jagathsrujan/mcp2515-can-bus-module/docs/pcb/drc_report.txt

** Drc report for MCP2515_CAN.kicad_pcb **
** Created on 2026-11-03T07:28:12 **
** Report includes: Errors, Warnings, Exclusions **

** Found 0 DRC violations **

** Found 0 unconnected pads **

** Found 0 Footprint errors **

** Ignored checks **
    - Footprint has no courtyard defined
    - Track endpoint not centered on via
    - Tuning profile track geometries
    - Footprint doesn't match symbol's footprint filters
    - Footprint component type doesn't match footprint pads

** End of Report **
