jagathsrujan/mcp2515-can-bus-module/docs/pcb/layout_report.md

# Phase 7 - PCB layout report (MCP2515 CAN module, Rev A)

Board: `kicad/MCP2515_CAN/MCP2515_CAN.kicad_pcb`, KiCad 10.0.8, 2-layer 1.6 mm, **70 x 50 mm** (plan 60x45 first; grown to the plan's 70x50 maximum, see Deviations). Origin = aux/grid origin at bottom-left (CPL positions below are X right, Y up in mm from that corner). Generated by scripts in the session scratchpad (placement legalizer, grid A* router, zone/stitching/silk scripts); CAN pair routed by hand-coordinates.

## 0. Footprint verification
| Part | Result | Source |
|---|---|---|
| J1 PJ-002AH (P-01) | Pad positions **verified correct**: pin1 (centre, slot 1.00x3.50) at origin, pin2 (sleeve, 1.00x3.00) 6.0 mm on-axis, pin3 (switch, 3.00x1.00) 3.0 along / 4.7 off-axis; jack front 10.7 mm ahead of pin3. Slots plated, finished slot = tab + 0.5 mm (tabs 3.0/2.5 wide, 0.25-0.4 thick). Pads 3.5x4.5 / 3.0x4.0 / 4.0x3.0 (>=0.5 mm ring). Fixed: courtyard (was y -5..10, now body 14.4x9.0 + pin3), silk moved off pads/edge, removed "PROVISIONAL" text, descr updated. | CUI PJ-002AH datasheet 10/30/2019 p2 (LCSC C2961147) |
| J3/J4/J5 KF128-5.08 (P-02) | Pin 0.9x0.8 mm (diag 1.2), recommended hole 1.4 +0.1, pitch 5.08, body 10.7 deep, pin 5.4 from body edge. Phoenix MKDS footprint had 1.3 mm drill (too tight): new project footprints `KF128-5.08-3P_Horizontal` / `-2P_Horizontal` with **1.4 mm drill, 2.6 mm pad (0.6 ring)**; outline/3D from Phoenix MKDS (approximation). | Kefa KF128-5.08 drawing (LCSC C474953 datasheet) |
| L2 ACT45B (P-03) | Land pattern kept (pads 1.35x0.9, DNP, R16/R17 fitted). Pin1 CANH_T upper-left, pins 1-4 / 2-3 windings match netlist. | TDK ACT45B p5 (earlier work) |
| U1 SOIC-18W | pin1 top-left (CCW numbering) = MCP2515 pin1 TXCAN; placed rot 180. | KiCad lib, MCP2515 DS |
| U2 SOIC-8 TCAN1042 | pin1 TXD, 2 GND, 3 VCC, 4 RXD, 5 VIO, 6 CANL, 7 CANH, 8 STB = netlist. | TCAN1042 DS |
| U3 TSOT-23-6 AP63205 | 1 FB, 2 EN, 3 VIN, 4 GND, 5 SW, 6 BST = netlist. U4 SOT-23-3 XC6206: 1 GND, 2 OUT, 3 IN = netlist. | datasheets |
| D1 SS34 / D2 SMAJ18A (D_SMA) | pin1 = cathode: D1 K on VIN_PROT (A on VIN_F), D2 K on VIN_PROT, A GND. D3 SOT-23 PESD2CANFD27V: 1 CANH, 2 CANL, 3 GND. D4 LED 0603: pin1 K=GND, pin2 A. | netlist / KiCad conventions |
| C1 CP_Elec_6.3x7.7 | pad1 = +, on VIN_PROT. Y1 3225-4: pins 1/3 crystal (OSC1/OSC2_X), 2/4 GND. | KiCad lib |

Schematic edit (non-electrical): Footprint field of J3, J4, J5 changed to `MCP2515_CAN:KF128-5.08-3P_Horizontal` / `-2P_...` so DRC schematic parity stays clean. ERC re-run: 0 violations. Originals backed up in the scratchpad.

## 1. Placement (X, Y up from bottom-left, rot deg CCW; footprint origin)
| Ref | X | Y | Rot |
|---|---|---|---|
| C1 | 35.00 | 9.50 | 0 |
| C10 | 34.85 | 44.00 | -90 |
| C11 | 31.78 | 42.20 | -90 |
| C12 | 35.65 | 24.60 | 90 |
| C13 | 36.00 | 20.50 | 0 |
| C14 | 42.90 | 20.50 | 0 |
| C15 | 33.15 | 35.85 | 90 |
| C16 | 37.00 | 29.25 | -90 |
| C17 | 16.26 | 23.92 | 180 |
| C18 | 11.50 | 41.00 | 180 |
| C19 | 56.00 | 38.50 | 0 |
| C2 | 42.90 | 10.00 | 90 |
| C3 | 42.90 | 15.25 | 90 |
| C4 | 47.00 | 6.90 | 0 |
| C5 | 52.50 | 16.00 | 180 |
| C6 | 52.50 | 19.05 | 180 |
| C7 | 49.20 | 13.40 | 0 |
| C8 | 44.90 | 41.50 | 0 |
| C9 | 36.90 | 40.55 | 180 |
| D1 | 25.50 | 9.50 | 180 |
| D2 | 25.50 | 4.50 | 180 |
| D3 | 62.00 | 25.70 | 0 |
| D4 | 45.70 | 3.50 | 0 |
| F1 | 19.00 | 9.50 | 0 |
| FB1 | 36.00 | 15.50 | 0 |
| FID1 | 3.50 | 35.00 | 0 |
| FID2 | 45.00 | 46.50 | 0 |
| FID3 | 57.00 | 3.50 | 0 |
| H1 | 66.50 | 3.00 | 0 |
| H2 | 3.50 | 46.50 | 0 |
| J1 | 13.70 | 9.50 | 0 |
| J2 | 31.78 | 45.60 | -90 |
| J3 | 64.35 | 30.75 | 90 |
| J4 | 64.35 | 10.50 | 90 |
| J5 | 5.65 | 25.00 | -90 |
| JP1 | 48.00 | 33.54 | 0 |
| L1 | 51.80 | 10.00 | 0 |
| L2 | 48.00 | 24.60 | 0 |
| R1 | 42.00 | 3.50 | 0 |
| R10 | 15.00 | 27.00 | 0 |
| R11 | 50.00 | 37.00 | 0 |
| R12 | 54.50 | 36.25 | 0 |
| R13 | 54.50 | 31.00 | 0 |
| R14 | 54.50 | 33.40 | 0 |
| R15 | 42.50 | 28.80 | 0 |
| R16 | 48.00 | 27.75 | 0 |
| R17 | 48.00 | 21.45 | 0 |
| R2 | 15.25 | 42.50 | 0 |
| R3 | 14.50 | 39.50 | 90 |
| R4 | 31.00 | 30.70 | -90 |
| R5 | 26.70 | 41.75 | 90 |
| R6 | 24.16 | 41.75 | 90 |
| R7 | 19.08 | 41.75 | 90 |
| R8 | 21.62 | 41.75 | 90 |
| R9 | 16.79 | 39.50 | 90 |
| SJ1 | 39.50 | 37.80 | 0 |
| TP1 | 31.00 | 14.75 | 0 |
| TP10 | 44.25 | 33.54 | 0 |
| TP11 | 48.30 | 18.30 | 0 |
| TP12 | 40.00 | 31.55 | 0 |
| TP2 | 56.50 | 6.75 | 0 |
| TP3 | 37.75 | 45.05 | 0 |
| TP4 | 41.00 | 46.00 | 0 |
| TP5 | 18.00 | 4.00 | 0 |
| TP6 | 32.00 | 26.00 | 0 |
| TP7 | 8.00 | 40.00 | 0 |
| TP8 | 32.00 | 22.00 | 0 |
| TP9 | 31.50 | 18.75 | 0 |
| U1 | 24.00 | 29.00 | 180 |
| U2 | 40.50 | 24.60 | 0 |
| U3 | 47.00 | 10.00 | 0 |
| U4 | 41.00 | 41.50 | 0 |
| Y1 | 34.00 | 31.70 | -90 |

Fixed: H1 (66.5,3.0), H2 (3.5,46.5) M3, 3 mm (r=4.6) keep-out rule areas; FID1 (3.5,35), FID2 (45,46.5), FID3 (57,3.5). J1/J5 face the left edge, J3/J4 the right edge (entry outward, 0.3 mm inset so silk clears the edge), J2 on the top edge, SMD courtyards >= 2.5 mm from edges (min 2.7 mm, TP4; D2 moved to y=4.5; fiducial courtyards 2.2 mm are exempt).

## 2. Rules / pours
Board setup + netclasses in `.kicad_pro`: min track/clearance 0.15/0.15, via 0.3/0.6, annular 0.15, hole-hole 0.5, edge 0.5, silk 0.15/1.0/0.15, mask 0.05/0.1; Default 0.20/0.20, Power 0.5/0.2 (0.3 fallback where space is tight: yes, some branches), SW 0.6/0.25, CAN 0.25 (gap 0.20).
Pours: Z1 B.Cu GND whole board, prio 0, clearance 0.3, min width 0.25, thermal relief (0.4 spoke / 0.3 gap) on THT GND pads, solid on SMD/vias, islands removed; Z2 F.Cu GND same; Z3 F.Cu VIN_PROT local pour (26.9-35.4, 3.4-16.4) prio 1; Z4 F.Cu +5V local pour at L1/C5/C6 prio 1; pour keep-out rule areas around both mounting holes. Z3 as built covers VIN_PROT only (D1.K, D2.K, C1+, FB1, TP1); no separate VIN_BUCK pour (0.5 mm traces, ~0.13 A).
Stitching/GND vias: 150 vias total, 126 GND = 27 at SMD GND pads (every decoupling-cap GND pad; D2 and D3 have >=2 each incl. stitching), 40 edge ring (~5 mm), 44 grid (~8 mm), 11 Y1 guard ring, 3 along the CAN pair. Bottom layer is a solid GND plane except signal jumpers (below).

## 3. Measured key checks (plan section 8)
- DRC (`kicad-cli pcb drc --all-track-errors --schematic-parity --severity-all`): **0 violations, 0 unconnected, 0 parity issues** (docs/pcb/drc_report.txt).
- Y1-L1 centre distance **28.1 mm** (>=10); Y1 to SW pad (U3.5) 25.9 mm; Y1 to nearest CAN-pair item (D3/L2/R16/JP1/U2 CAN pads) **11.1 mm** (>=5). Nothing but GND under Y1/C15/C16 on bottom (bottom keep-out for signals).
- Oscillator track length (pad centres): OSC1 5.85, OSC2 1.95, OSC2_X 5.76 mm (plan <=5 mm each: OSC1/OSC2_X **exceed by ~0.8-0.9 mm**, no vias, short symmetric top-layer; crystal placement limited by U1 courtyard).
- CAN pair (rev. after Opus review): **D3 now sits in the gap between J3 and J4 at (62.0,25.7)**, J3 moved to pin1 y=30.75, J4 to 10.5. Routed lengths pin -> D3 pad (pad centres): J3 CANH 18.89 / CANL 18.89 mm (straight 5.3 / 11.6); J4 CANH 25.56 / CANL 25.56 (straight 16.5 / 9.7); mismatch 0.00 on each. D3->U2 via R16/R17: 20.19 / 20.44 mm. The "<=5 mm routed" target is met only for J3 CANH (~5.3 straight); **not achievable for the other three pins**: J3/J4 pins are on a 5.08 mm pitch, so L3/H4/L4 are 9.7-16.5 mm from any single D3 position. Routing order is J3/J4 -> D3 pads -> trunk -> JP1/R11-R14 -> R16/R17 (L2) -> U2; D3 GND pad has 2 dedicated GND vias at (64.8,25.7)/(66.4,25.7) plus 2 stitching vias nearby. 0.25 mm tracks on the top layer; 4 vias (two bottom jumpers, CANL via 58.8 mm column and CANH via 58.0 column) because J3/J4 pin order alternates H,L,H,L; short stubs carry detours/one meander each (right-hand detours) to equalise lengths.
- Decoupling (cap power pad centre -> IC pin pad centre; edge gap in brackets approx.): C4->U3.3 2.18 mm, C8->U4.3 1.99, C9->U4.2 2.01, C14->U2.5 2.35, C12->U2.3 2.38, C17->U1.18 2.31, C11->J2.1 2.62, C2->U3.3 3.01; bulk C10 3.1, C13 4.6, C3 5.6, C5 6.0, C6 9.1 (bulk, not pin-critical). Wide SOIC pads make centre-centre >2 mm unavoidable at 0.25 mm courtyard gaps; pad-edge gaps are all <=1.9 mm. Every cap has a GND via at its GND pad.
- Buck hot loop C4-U3 (VIN_BUCK/GND pads, trapezoid C4.1,U3.3,U3.4,C4.2): **4.1 mm2** (<10); C4 directly below U3. SW is a 0.6 mm top-layer track U3.5 -> L1.1 (+C7), no vias, GND plane below; FB routed as a separate 0.3 mm trace to the C6 +5V pad.
- GND plane continuity: B.Cu pour one single outline (verified, only the CAN jumper and few signal jumper traces cut it); top pour has 5 islands, each stitched to B.Cu by vias (DRC clean).
- Silk: all text 1.0 mm / 0.15; refs only for ICs/connectors/diodes/etc., passives refs on F.Fab; silk-to-pad and silk-edge DRC 0.

## 4. Tool results
- MCP `get_courtyard_violations`: none. `get_silk_to_pad_violations`: none. `dfm_load_manufacturer_profile` JLCPCB/standard + `dfm_run_manufacturer_check`: PASS DRC 0, unconnected 0, courtyard 0, silk 0; WARN (profile cannot read board-level min track/via/layers without a live KiCad session; manual review items: annular ring, copper-edge, silk height - all met by DRC rules above).
- MCP `emc_*` tools need an open KiCad IPC session (BOARD_NOT_OPEN) - not run; equivalents measured above. `pcb_critique_placement`: warnings are heuristic (e.g. bulk caps vs nearest IC, FB1 taken as a "crystal") - none affect the actual constraints.
- Exports: STEP, renders (top/bottom/iso), F.Cu/B.Cu images (pour and tracks-only) in docs/pcb/.

## 5. Deviations / open items
1. Board 70x50 instead of 60x45: SMD courtyard margins, 12 test points, two 15 mm terminal blocks plus 5 mm header and 0.25-0.5 mm courtesy gaps could not be packed in 60x45.
2. CAN pair has **4 vias** (CANH and CANL bottom jumpers next to D3) and TX/RX/INT/MISO-type signals use a few bottom jumpers (STB, RXCAN, INT_U/INT_N, RST). Reason (CAN): J3 and J4 are identical outward terminals so pin order H,L,H,L along the edge is topologically non-planar on one layer; frozen schematic forbids swapping. Plan stated "no vias" - report.
3. OSC1/OSC2_X 5.8 mm (>5 mm target).
4. The CAN pair is not tightly coupled over its whole length (D3 pads/R16/R17/L2 geometry); skew is zero by construction.
5. Decoupling caps: centre-distance >2 mm for wide-pad ICs (see list); edge gaps <=2 mm.
6. Power tracks: some 0.3 mm instead of 0.5 mm; +5V and VIO routes are long diagonals (auto-routed) - functional, DRC clean, cosmetic.
7. No VIN_BUCK pour; Z3/Z4 are modest local pours.
8. J3-J5 use Phoenix 3D model (approximate); J1 has no 3D model (blank in renders).
9. Schematic footprint fields for J3/J4/J5 changed (non-electrical). docs BOM CSVs from phase 6 still show the old footprint name.
10. JLC order-number placeholder text and silk board name are present; legend of J2 pins uses two staggered rows above the header.

11. Rev. review fixes: D3 relocated to J3/J4 gap (see section 3); D2 edge clearance fixed; silk: "+" next to J5 pin 1 and "9V + centre" beside J1.
