jagathsrujan/mcp2515-can-bus-module/docs/schematic/erc_report.txt

ERC report (2026-11-03T06:22:05, Encoding UTF8)
Report includes: Errors, Warnings

***** Sheet /

***** Sheet /Power/

***** Sheet /Controller/

***** Sheet /CAN PHY/

 ** ERC messages: 0  Errors 0  Warnings 0

 ** Ignored checks:
    - Global label only appears once in the schematic
    - Four connection points are joined together
    - SPICE model issue
    - Assigned footprint doesn't match footprint filters
