jagathsrujan/mcp2515-can-bus-module/docs/pcb/B_Cu_tracks.png

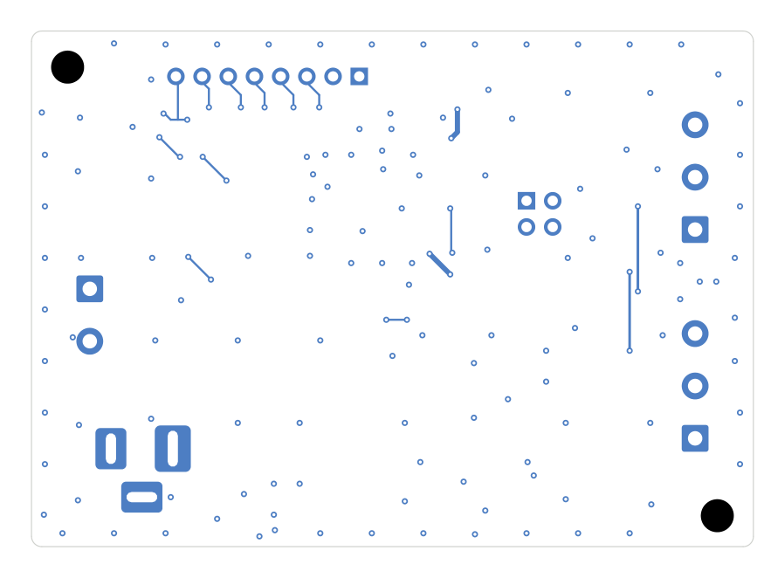
docs/pcb/B_Cu_tracks.png
