jagathsrujan/mcp2515-can-bus-module/docs/pcb/F_Cu_pour.png

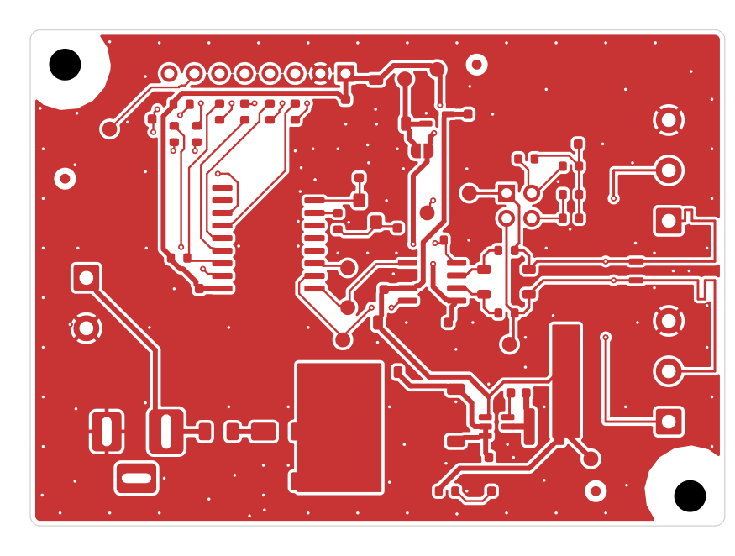
docs/pcb/F_Cu_pour.png
