jagathsrujan/mcp2515-can-bus-module/docs/pcb/render_bottom.png

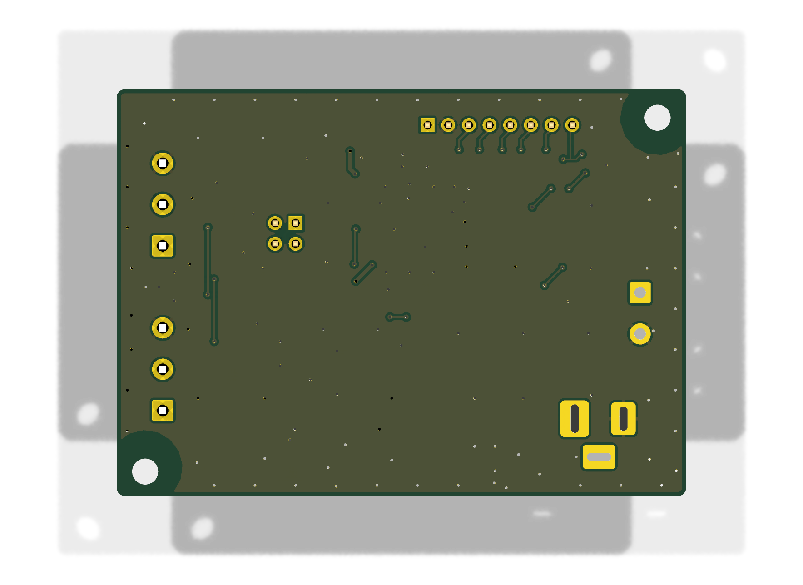
docs/pcb/render_bottom.png
