jagathsrujan/mcp2515-can-bus-module/docs/pcb/render_top.png

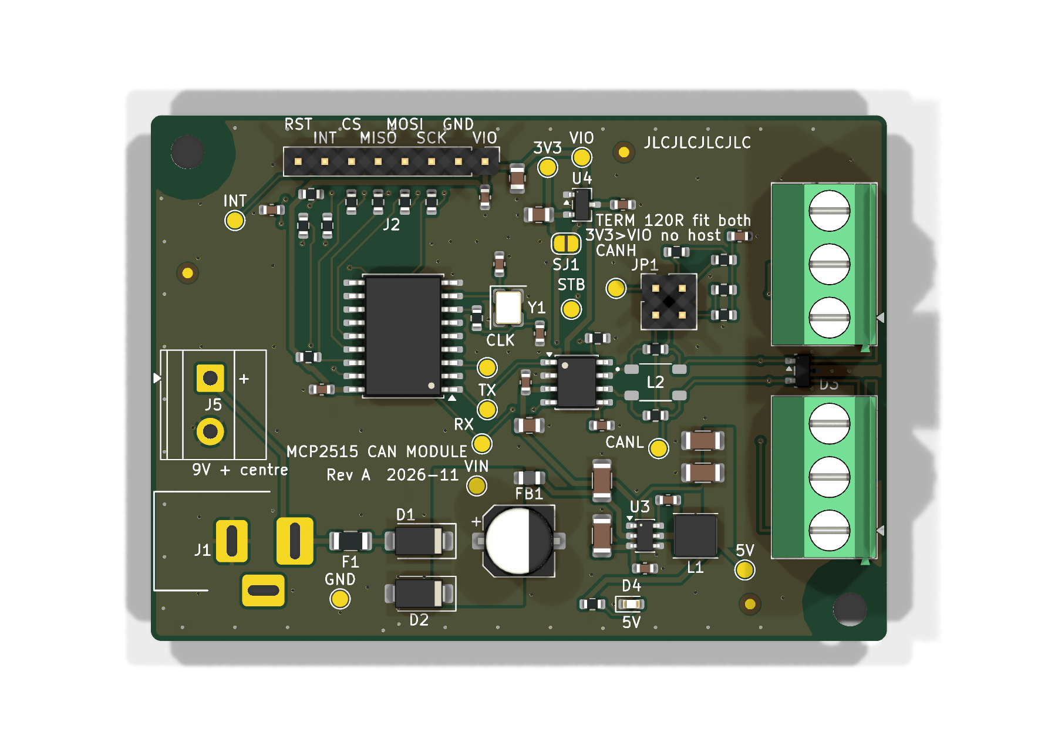
docs/pcb/render_top.png
