jagathsrujan/mcp2515-can-bus-module/docs/schematic/MCP2515_CAN_0_root.png

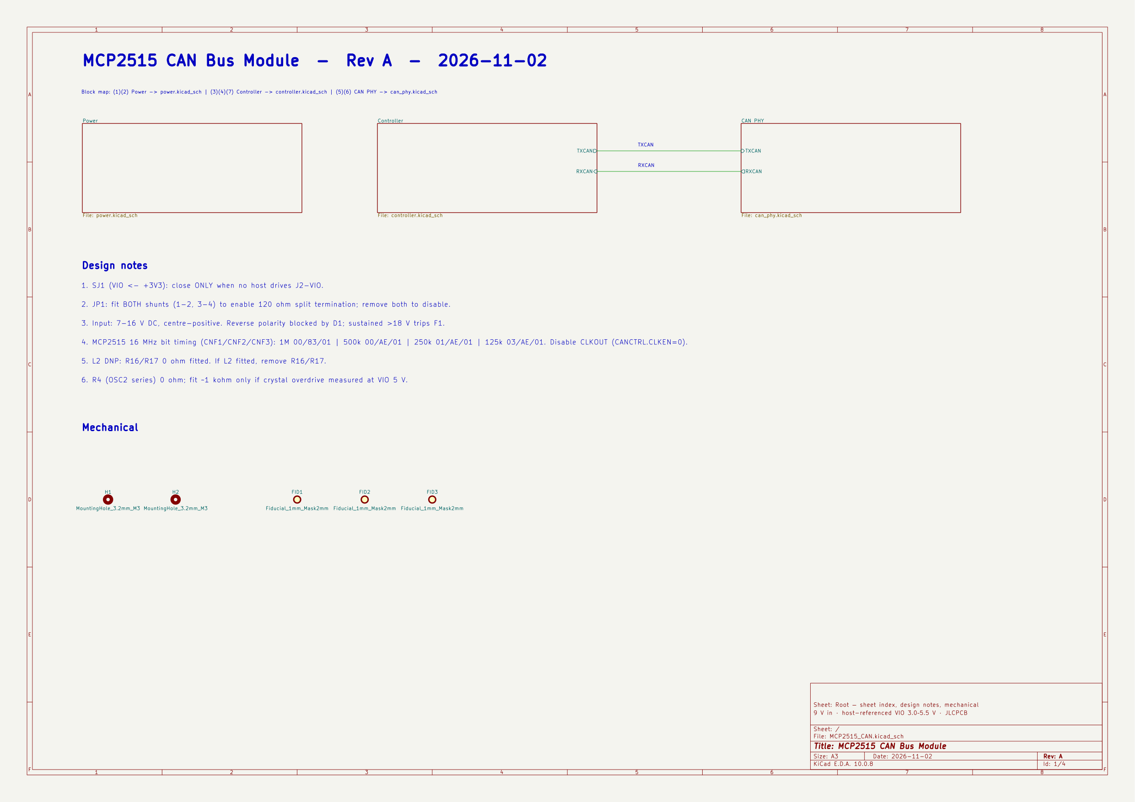
docs/schematic/MCP2515_CAN_0_root.png
