jagathsrujan/mcp2515-can-bus-module/docs/schematic/MCP2515_CAN_1_power.png

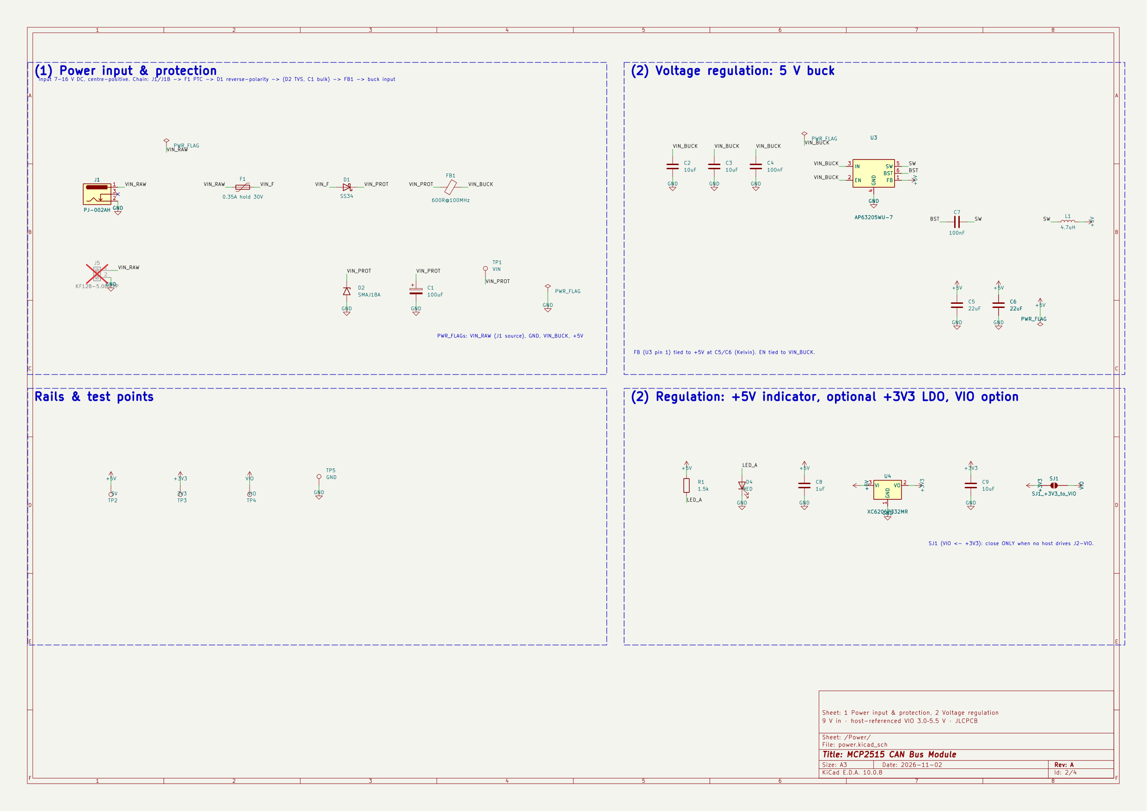
docs/schematic/MCP2515_CAN_1_power.png
