jagathsrujan/mcp2515-can-bus-module/docs/schematic/MCP2515_CAN_2_controller.png

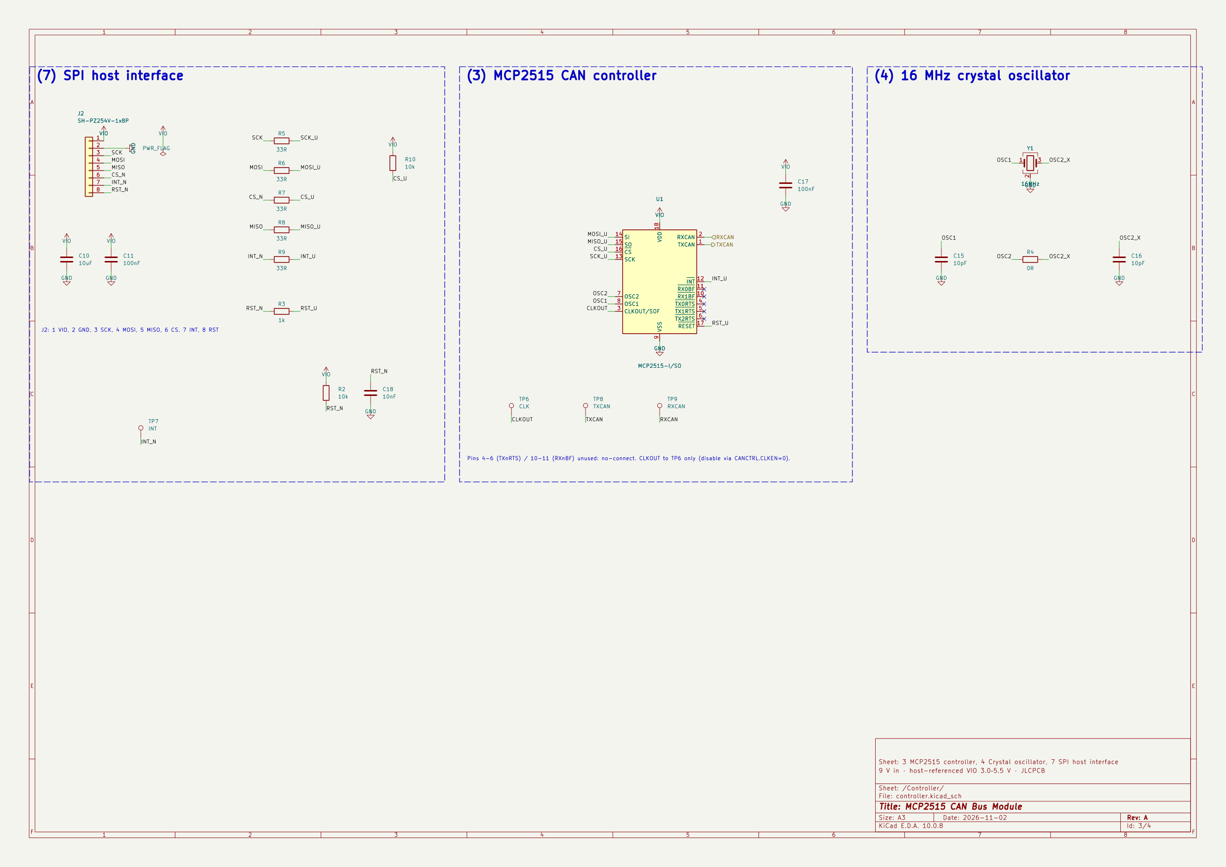
docs/schematic/MCP2515_CAN_2_controller.png
