jagathsrujan/mcp2515-can-bus-module/docs/schematic/MCP2515_CAN_3_can_phy.png

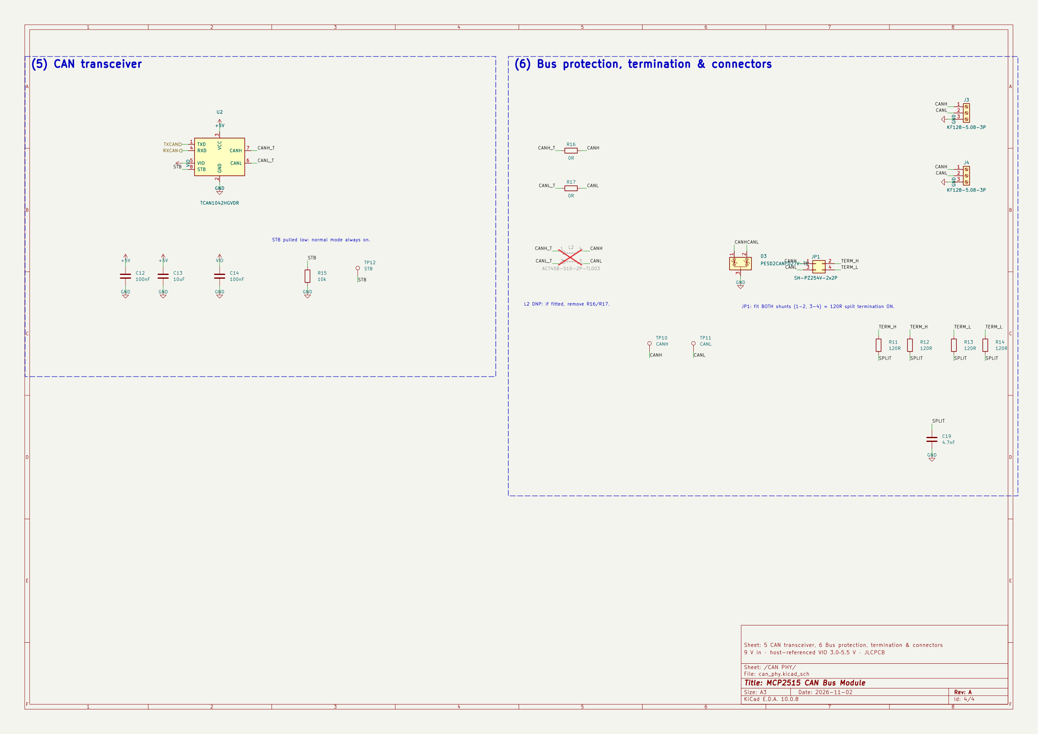
docs/schematic/MCP2515_CAN_3_can_phy.png
