jagathsrujan/mcp2515-can-bus-module/docs/BOM_master.csv

Ref | Qty | Value/Function | MPN | Manufacturer | Package | LCSC | JLC class | Status | Notes
U1 | 1 | CAN controller | MCP2515T-I/SO | Microchip | SOIC-18W | C153782 | Extended | APPROVED | VDD=VIO; was C12368 (JLC: no longer manufactured)
U2 | 1 | CAN transceiver | TCAN1042HGVDR | Texas Instruments | SOIC-8 | C124014 | Extended | PROPOSED | Alt TJA1051T/3/1J C38695; MCP2562-E/SN C53609
U3 | 1 | 5V buck regulator | AP63205WU-7 | Diodes Inc | TSOT-26 | C2071056 | Extended | PROPOSED | EN tied to VIN
L1 | 1 | 4.7uH 2.35A shielded | SWPA4020S4R7MT | Sunlord | 4x4x2mm | C48427 | Extended | PROPOSED
U4 | 1 | 3.3V LDO (optional) | XC6206P332MR | Torex | SOT-23 | C5446 | Basic | PROPOSED | Pinout 1 VSS 2 VOUT 3 VIN
D1 | 1 | Reverse-polarity Schottky 40V 3A | SS34 | MDD | SMA | C8678 | Basic | PROPOSED
D2 | 1 | Input TVS 18V 400W | SMAJ18A | Littelfuse | SMA | C148219 | Extended | PROPOSED
D3 | 1 | CAN ESD TVS 27V | PESD2CANFD27V-TR | Nexperia | SOT-23 | C552488 | Extended | PROPOSED | DS verified
L2 | 1 | CAN common-mode choke | ACT45B-510-2P-TL003 | TDK | 4-pad SMD | C76584 | Extended | DNP | 0R bypass fitted
Y1 | 1 | 16MHz crystal CL 9pF | X322516MLB4SI | YXC | 3225-4 | C13738 | Basic | PROPOSED
R_TERM | 4 | 120R 1% 0603 | 0603WAF1200T5E | UNI-ROYAL | 0603 | C22787 | Basic | PROPOSED | 2 parallel per leg
C_TERM | 1 | 4.7nF 50V X7R 0603 | 0603B472K500NT | FH | 0603 | C53987 | Basic | PROPOSED
LED1 | 1 | Red LED | KT-0603R | Hubei KENTO | 0603 | C2286 | Basic | PROPOSED
J1 | 1 | DC barrel jack 5.5x2.1 | PJ-002AH | CUI | THT | C2961147 | Extended | PROPOSED
J5 | 1 | 2-pin 5.08 terminal (alt power) | KF128-5.08-2P | Cixi Kefa | THT | C474952 | Extended | DNP
J3;J4 | 2 | 3-pin 5.08 CAN terminal | KF128-5.08-3P | Cixi Kefa | THT | C474953 | Extended | PROPOSED
J2 | 1 | 1x8 2.54 header | SH-PZ254V-1x8P | SHOU HAN | THT | C55629815 | Extended | PROPOSED
JP1 | 1 | 2x2 2.54 header (term) | SH-PZ254V-2x2P | SHOU HAN | THT | C55629823 | Extended | PROPOSED | 2 shunts C100114 hand-fit
C_DEC | TBD | 100nF 50V X7R 0603 | CC0603KRX7R9BB104 | YAGEO | 0603 | C14663 | Basic | PROPOSED | Qty in Phase 6
C5;C6 | 2 | 22uF 25V X5R 1206 (buck out) | CL31A226KAHNNNE | Samsung | 1206 | C12891 | Basic | PROPOSED | 27.2uF eff at 5V
C_10U | TBD | 10uF 25V X5R 0805 | CL21A106KAYNNNE | Samsung | 0805 | C15850 | Basic | PROPOSED
R_10K | TBD | 10k 1% 0603 | 0603WAF1002T5E | UNI-ROYAL | 0603 | C25804 | Basic | PROPOSED
R_1K5 | 1 | 1.5k 1% 0603 | 0603WAF1501T5E | UNI-ROYAL | 0603 | C22843 | Basic | PROPOSED | LED
C15;C16 | 2 | 10pF C0G 50V 0603 (crystal) | CL10C100JB8NNNC | Samsung | 0603 | C1634 | Basic | PROPOSED | Bench trim
F1 | 1 | PTC 0.35A hold 30V | 0ZCJ0035AF2E | Bel Fuse | 1206 | C6378052 | Extended | PROPOSED | Alt BSMD1206-035-30V C910829
C1 | 1 | 100uF 35V Al electrolytic | FZ100UF35V90RV0064 | KNSCHA | 6.3x7.7mm | C2992596 | Extended | PROPOSED | Input damping
FB1 | 1 | Ferrite bead 600R@100MHz 500mA | GZ2012D601TF | Sunlord | 0805 | C1017 | Basic | PROPOSED
C2;C3 | 2 | 10uF 50V X5R 1206 (buck in) | CL31A106KBHNNNE | Samsung | 1206 | C13585 | Basic | PROPOSED
C8 | 1 | 1uF 50V X5R 0603 (U4 in) | CL10A105KB8NNNC | Samsung | 0603 | C15849 | Basic | PROPOSED
C_RST | 1 | 10nF 50V X7R 0603 | TBD-Basic | TBD | 0603 | C57112 | Basic | PROPOSED | Reset RC
R_SPI | 5 | 33R 1% 0603 | 0603WAF330JT5E | UNI-ROYAL | 0603 | C23140 | Basic | PROPOSED | SCK MOSI MISO CS INT
R_S | 1 | 0R 0603 (OSC2 series) | 0603WAF0000T5E | UNI-ROYAL | 0603 | C21189 | Basic | PROPOSED | Fit ~1k if overdrive
R_RSER | 1 | 1k 1% 0603 | 0603WAF1001T5E | UNI-ROYAL | 0603 | C21190 | Basic | PROPOSED | Reset series
R_STB | 1 | 10k 1% 0603 (STB pull-down) | 0603WAF1002T5E | UNI-ROYAL | 0603 | C25804 | Basic | PROPOSED
R_CMC | 2 | 0R 0603 (CMC bypass) | 0603WAF0000T5E | UNI-ROYAL | 0603 | C21189 | Basic | PROPOSED | Remove if L2 fitted
