jagathsrujan/mcp2515-can-bus-module/docs/power_budget.xlsx

Sheet: Inputs
Inputs / assumptions (yellow = editable). Source: docs/phase3_power_supply.md unless noted
Name | Value | Unit | Tag | Source
Vf_D1 | 0.34 | V | (curve) | SS34 Vf at 100 mA, MDD SS32-SS3200 Rev 2024A5 Fig.3 p2; phase3 s4.1
Eff_buck | 0.9 | - | [ASSUME] | AP63205 >=90 % at 9 V (curve only at 12 V: 91.8 %, Fig.2 p2); phase3 s3.2
fsw | 1100000 | Hz | [DS] | AP63205 DS41326 p5, 1.1 MHz typ
L_ind | 4.7e-06 | H | [DS]/[LIST] | SWPA4020S4R7MT C48427; AP63205 Table 3 p13
Cout_eff | 2.72e-05 | F | [SIM] | 2x CL31A226KAHNNNE at 5 V, -38 % (Samsung SEM); power_stage_extract s7
Vout | 5 | V | [DS] | AP63205 fixed 5.0 V, p5
Iload | 0.1 | A | design | phase3 s2 design value, continuous
Iload_max | 0.15 | A | design | phase3 s2 design value, max
ton_min | 8e-08 | s | [DS] | AP63205 minimum on-time, p5
theta_buck | 89 | C/W | [DS] | AP63205 TSOT26 theta-JA, p4
theta_LDO_A | 64 | C/W | [DS] | SOT-223 JEDEC 2s2p (TPS7B6950 64.2), TI SLVSCJ8B p4
theta_LDO_B | 90 | C/W | [ASSUME] | realistic 2-layer board; phase3 s3.1
Tamb_lo | 25 | C | - | phase3 s3.1
Tamb_hi | 85 | C | - | phase3 s3.1 (AP63205 TA max 85 C)
Tj_max | 150 | C | - | LDO Tj limit used in phase3 s3.1
Vclamp | 29.2 | V | [DS] | SMAJ18A Vc @13.7 A, Littelfuse SMAJ p2
Eta12_ds | 0.918 | - | (curve) | AP63205 Fig.2 p2, 12 V / 100 mA
Vin cases (V)
Vin case | 7 | V |  | DR-01 lower limit
Vin case | 9 | V |  | nominal adapter
Vin case | 12 | V |  | mis-plugged / loaded 12 V adapter
Vin case | 16 | V |  | DR-01 upper limit
Vin case | 29.2 | V |  | SMAJ18A clamp Vc

Sheet: Load budget
Current budget, mA (phase3 s2). 'Conc.' = 1 if included in the +5V worst-case sum (dominant and recessive are mutually exclusive)
Load | Rail | Typ (mA) | Max (mA) | Conc. (1/0) | Source / tag
TCAN1042HGV VCC, dominant into 60 ohm | +5V | 40 | 70 | 1 | [DS] SLLSES7D s7.7 p9
TCAN1042HGV VCC, recessive | +5V | 1.5 | 2.5 | 0 | [DS] SLLSES7D s7.7 p9 (excluded: exclusive with dominant)
Power LED KT-0603R, 1.5 kohm | +5V | 2 | 2.1 | 1 | [CALC] (5-1.8)/1.5k = 2.13 mA; LED Vf at 2 mA not in datasheet
XC6206 -> VIO (SJ1 closed, no host) | +5V | 6 | 12 | 1 | [DS]/[CALC] MCP2515 IDD 10 mA max (DS20001801K T13-1) + TCAN IIO 0.3 mA + pull-ups ~1 mA + XC6206 Iq 1 uA
+5V sum of concurrent loads |  |  |  |  | phase3 quotes ~85 mA
+5V sum of ALL listed max (not exclusive)
Design value continuous (mA)
Design value max (mA)
Margin: design 100 mA vs worst-case sum |  |  |  |  | phase3 claims >= 15 %
Margin: design 150 mA vs worst-case sum
Host VIO load (SJ1 open)
MCP2515 10 + TCAN IIO 0.3 + pull-ups ~0.5 | VIO | 6 | 10.8 |  | phase3 s2 (components sum as quoted, not re-derived)

Sheet: Buck
AP63205 buck, live formulas; load = Iload; D1 Schottky drop in front of buck
Vin (V) | Vbuck = Vin-Vf (V) | Duty = Vout/Vbuck | t_on (ns) | t_on > ton_min? | dIL Eq.7 (A) | Ripple cap term dIL/(8 f C) (mV) | Buck out power (W) | Input current from Vbuck (A) | Input current @Iload_max (A) | Buck loss (mW) | Schottky loss (mW) | Total input power (W) | End-to-end efficiency | Peak IL @Iload_max (A)
Cross-checks
Loss at 12 V/100 mA using datasheet 91.8 % (mW) |  |  |  |  |  |  | phase3: 45 mW
Temperature rise at that loss (K) |  |  |  |  |  |  | phase3: 4 K
Eq.10 min Cout for 100 mV overshoot @ 0.15 A + dIL/2 at 29.2 V (uF) |  |  |  |  |  |  | phase3: >= 1.1 uF (for 0.1 A-class); uses DS Eq.10 p14
Ceramic RMS input current approx Io*sqrt(D(1-D)) at D=0.5 (A) |  |  |  |  |  |  | phase3: 75 mA

Sheet: LDO compare
5 V LDO after D1 at Iload; red = Tj > Tj_max
Vin (V) | P_LDO = (Vin-Vf-Vout)*Iload (W) | dT @64 C/W (K) | dT @90 C/W (K) | Tj 64, 25C | Tj 64, 85C | Tj 90, 25C | Tj 90, 85C | Buck loss (mW) for comparison | LDO / buck loss ratio

Sheet: Sources
Number | Tag | Source (document, section, page) | URL
AP63205 VIN 3.8-32 V, abs max 35 V DC / 40 V 400 ms, fsw 1.1 MHz +-6 %, Vout 5.0 +-1 %, ton_min 80 ns, Iq 22 uA, SS 4 ms, theta-JA 89 C/W | [DS] | Diodes DS41326 Rev 3-2 Nov 2024, Abs Max/Recommended/Thermal p4, Electrical p5 | https://www.diodes.com/assets/Datasheets/AP63200-AP63201-AP63203-AP63205.pdf
AP63205 efficiency 91.8 % @12 V/100 mA, 90.1 % @10 mA | (curve) | DS41326 Fig.2 p2; 9 V curve NOT FOUND | same
AP63205 Eq.7 inductor ripple, Eq.10 Cout, 2x22 uF, 4.7 uH, 100 nF BST | [DS] | DS41326 p13-14, Table 3 p13 | same
EN tie to VIN, 450 mA PFM clamp, hiccup | [DS] | DS41326 p10-11 | same
SS34 Vf 0.34 V @100 mA, 0.36 V @200 mA; VRRM 40 V | (curve)/[DS] | MDD SS32-SS3200 Rev 2024A5, p1 table, Fig.3 p2 | https://www.lcsc.com/datasheet/lcsc_datasheet_2407101107_MDD-Microdiode-Semiconductor-SS34_C8678.pdf
SMAJ18A VWM 18 V, VBR 20-22.1 V, Vc 29.2 V @13.7 A | [DS] | Littelfuse SMAJ rev 11/20/15, p2 | https://static.chipdip.ru/lib/299/DOC012299232.pdf
TCAN1042HGV ICC dominant 70 mA max / recessive 2.5 mA max | [DS] | TI SLLSES7D s7.7 p9 (as cited in phase3 s2) | https://www.ti.com/lit/ds/symlink/tcan1042h.pdf (not re-read here)
MCP2515 IDD 10 mA max | [DS] | Microchip DS20001801K Table 13-1 (as cited in phase3 s2) | NOT RE-READ in this task
LED power 1.5 kohm, KT-0603R Vf 1.8-2.4 V @20 mA | [DS] | KENTO KT-0603R approval sheet Rev A.0, s4-6 p3-4 | https://www.lcsc.com/datasheet/lcsc_datasheet_1810231112_Hubei-KENTO-Elec-KT-0603R_C2286.pdf
LDO thermal: TPS7B6950 DCY 64.2 C/W; dropout 450/800 mV @100 mA | [DS] | TI SLVSCJ8B p4-5 | https://www.ti.com/lit/ds/symlink/tps7b69-q1.pdf
Cout_eff 2x CL31A226KAHNNNE = 27.2 uF @5 V (-38 %); C2/C3 CL31A106KBHNNN 4.4 uF @9 V, 2.3 uF @16 V | [SIM] | Samsung SEM simulation library; power_stage_extract s7 | https://product.samsungsem.com/mlcc/CL31A226KAHNNN.do
L1 SWPA4020S4R7MT: 4.7 uH, Isat 2.35 A, Irms 1.34 A, DCR 98 mOhm max | [DS] | Sunlord SWPA4020S catalogue p7 table | C48427 (see power_stage_extract s2)
XC6206P332MR: VIN 1.8-6 V, abs 7 V, 200 mA, dropout 250/680 mV @100 mA, pins 1 VSS 2 VOUT 3 VIN | [DS] | Torex ETR0305_004b p2-5 | https://www.lcsc.com/datasheet/lcsc_datasheet_2304140030_Torex-Semicon-XC6206P332MR-G_C5446.pdf
FB1 GZ2012D601TF: 600 ohm +-25 % @100 MHz, DCR 0.30 ohm max, Ir 500 mA; Z approx 5 ohm @1 MHz, 52 ohm @10 MHz, peak ~670 ohm @~130 MHz | [DS]/(curve) | Sunlord GZ catalogue (rev 2024/9/10) p3 table, p10 plot | https://www.lcsc.com/datasheet/lcsc_datasheet_2310301640_Sunlord-GZ2012D601TF_C1017.pdf
C1 FZ100UF35V90RV0064: 100 uF +-20 %, 35 V, surge 44 V, Z max 0.36 ohm @100 kHz 25 C, ripple 280 mA @100 kHz 105 C, tan d 14 %, 3000 h @105 C | [DS] | KNSCHA (Guangdong Kenisheng) approval sheet p1 | https://wmsc.lcsc.com/wmsc/upload/file/pdf/v2/lcsc/2204151800_KNSCHA-FZ100UF35V90RV0064_C2992596.pdf
F1 PTC 0ZCJ0035AF2E: Ihold 0.35 A, Itrip 0.75 A, Vmax 30 V, Rmin 0.30 / R1max 1.2 ohm, 0.1 s @8 A | [DS] | Bel Fuse 0ZCJ series p1; derating p3 (48 % @85 C) | https://wmsc.lcsc.com/wmsc/upload/file/pdf/v2/lcsc/2312110255_Bel-Fuse-0ZCJ0035AF2E_C6378052.pdf
Design values 100/150 mA, junction temp limit 150 C, ambient 25/85 C, theta 90 C/W | [ASSUME] | phase3_power_supply.md s2, s3.1 | docs/phase3_power_supply.md
