jagathsrujan/mcp2515-can-bus-module/docs/pcb/MCP2515_CAN.step

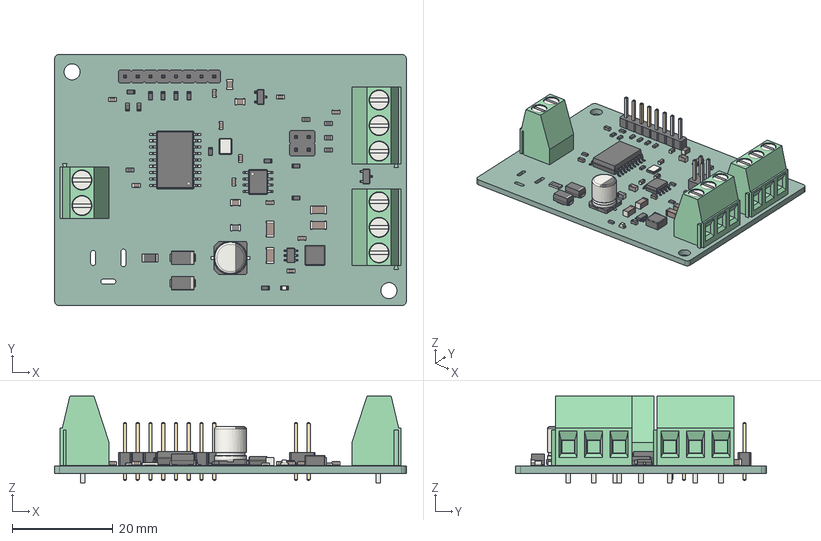
[picture p13: CAD file, 2026-11-03]
docs/pcb/MCP2515_CAN.step
70.0 x 50.0 x 17.3 mm
C_0603_1608Metric x 11
L_0805_2012Metric
CP_Elec_63x77
R_0603_1608Metric x 17
TerminalBlock_Phoenix_MKDS-1,5-3-5.08_1x03_P5.08mm_Horizontal x 2
D_SMA x 2
C_1206_3216Metric x 4
TerminalBlock_Phoenix_MKDS-1,5-2-5.08_1x02_P5.08mm_Horizontal
C_0805_2012Metric x 3
a671c444-8551-11ed-a139-00155d22e2d7_part
a671c57a-8551-11ed-a139-00155d22e2d7_part
a671c5fc-8551-11ed-a139-00155d22e2d7_part
PinHeader_1x08_P254mm_Vertical
SOT-23
PinHeader_2x02_P254mm_Vertical
LED_0603_1608Metric
Crystal_SMD_3225-4Pin_3.2x2.5mm
TSOT-23-6
SOT-23-3
SOIC-8_3.9x4.9mm_P1.27mm
SOIC-18W_7.5x11.6mm_P1.27mm
Fuse_1206_3216Metric
MCP2515_CAN_PCB
