jagathsrujan/mcp2515-can-bus-module/docs/schematic/MCP2515_CAN_schematic.pdf

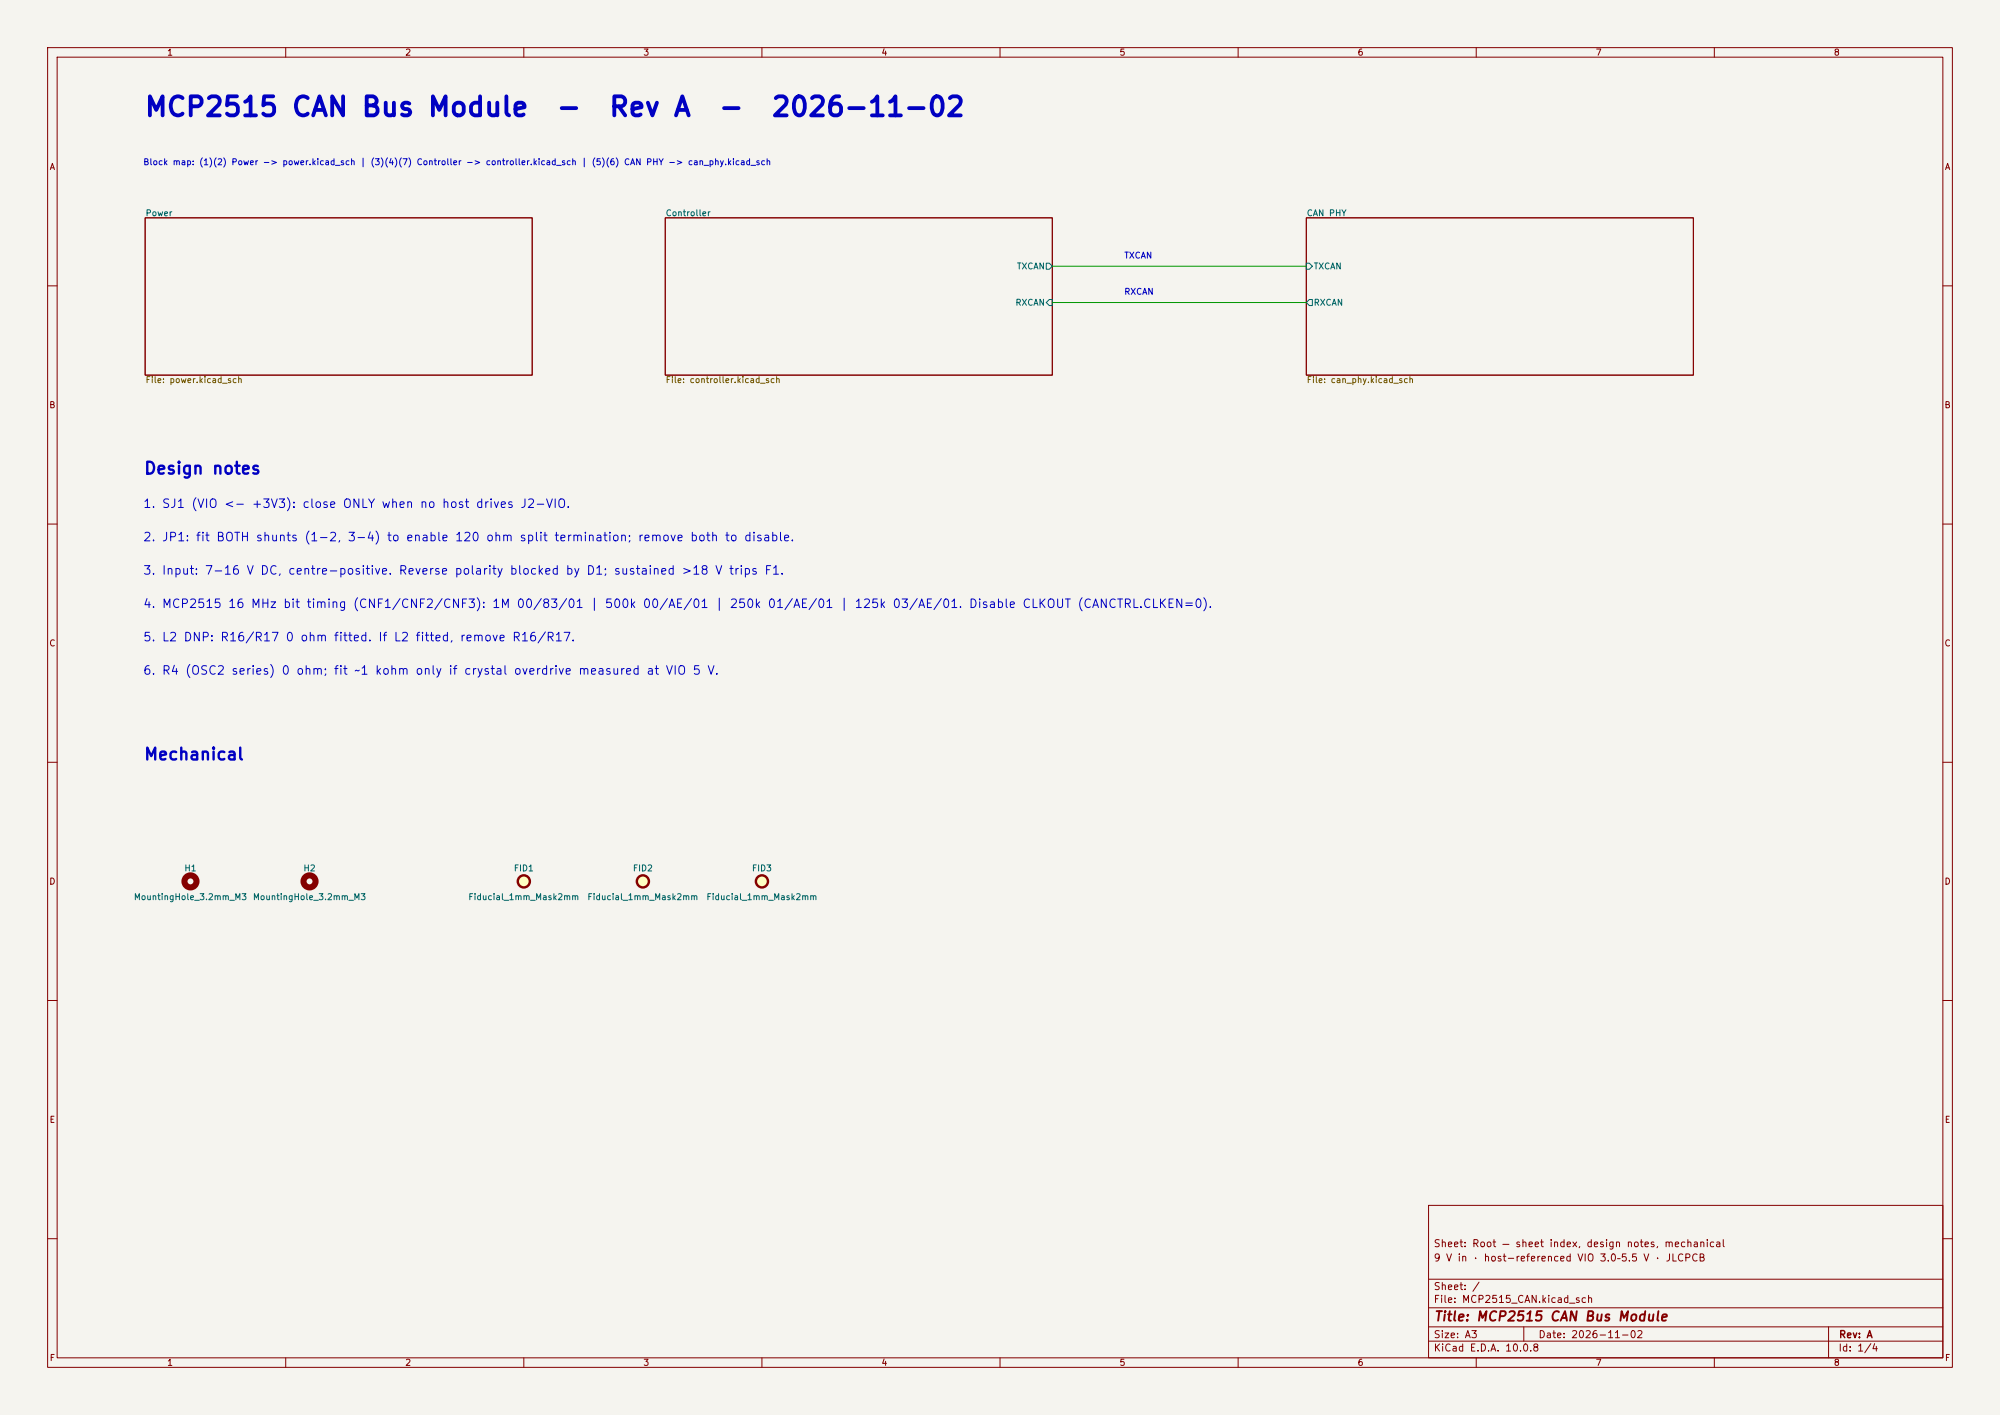
[picture p14: page 1]

Fiducial_1mm_Mask2mm MCP2515 CAN Bus Module - Rev A - 2026-11-02

Block map: (1)(2) Power -> power.kicad_sch | (3)(4)(7) Controller -> controller.kicad_sch | (5)(6) CAN PHY -> can_phy.kicad_sch

RXCAN 1. SJ1 (VIO <- +3V3): close ONLY when no host drives J2-VIO.

2. JP1: fit BOTH shunts (1-2, 3-4) to enable 120 ohm split termination; remove both to disable.

3. Input: 7-16 V DC, centre-positive. Reverse polarity blocked by D1; sustained >18 V trips F1.

4. MCP2515 16 MHz bit timing (CNF1/CNF2/CNF3): 1M 00/83/01 | 500k 00/AE/01 | 250k 01/AE/01 | 125k 03/AE/01. Disable CLKOUT (CANCTRL.CLKEN=0).

5. L2 DNP: R16/R17 0 ohm fitted. If L2 fitted, remove R16/R17.

6. R4 (OSC2 series) 0 ohm; fit ~1 kohm only if crystal overdrive measured at VIO 5 V.

Sheet: Root — sheet index, design notes, mechanical
9 V in · host-referenced VIO 3.0–5.5 V · JLCPCB

Sheet: /
File: MCP2515_CAN.kicad_sch
Title: MCP2515 CAN Bus Module

Size: A3 | Rev: A | F Date: 2026-11-02
KiCad E.D.A. 10.0.8 | Id: 1/4

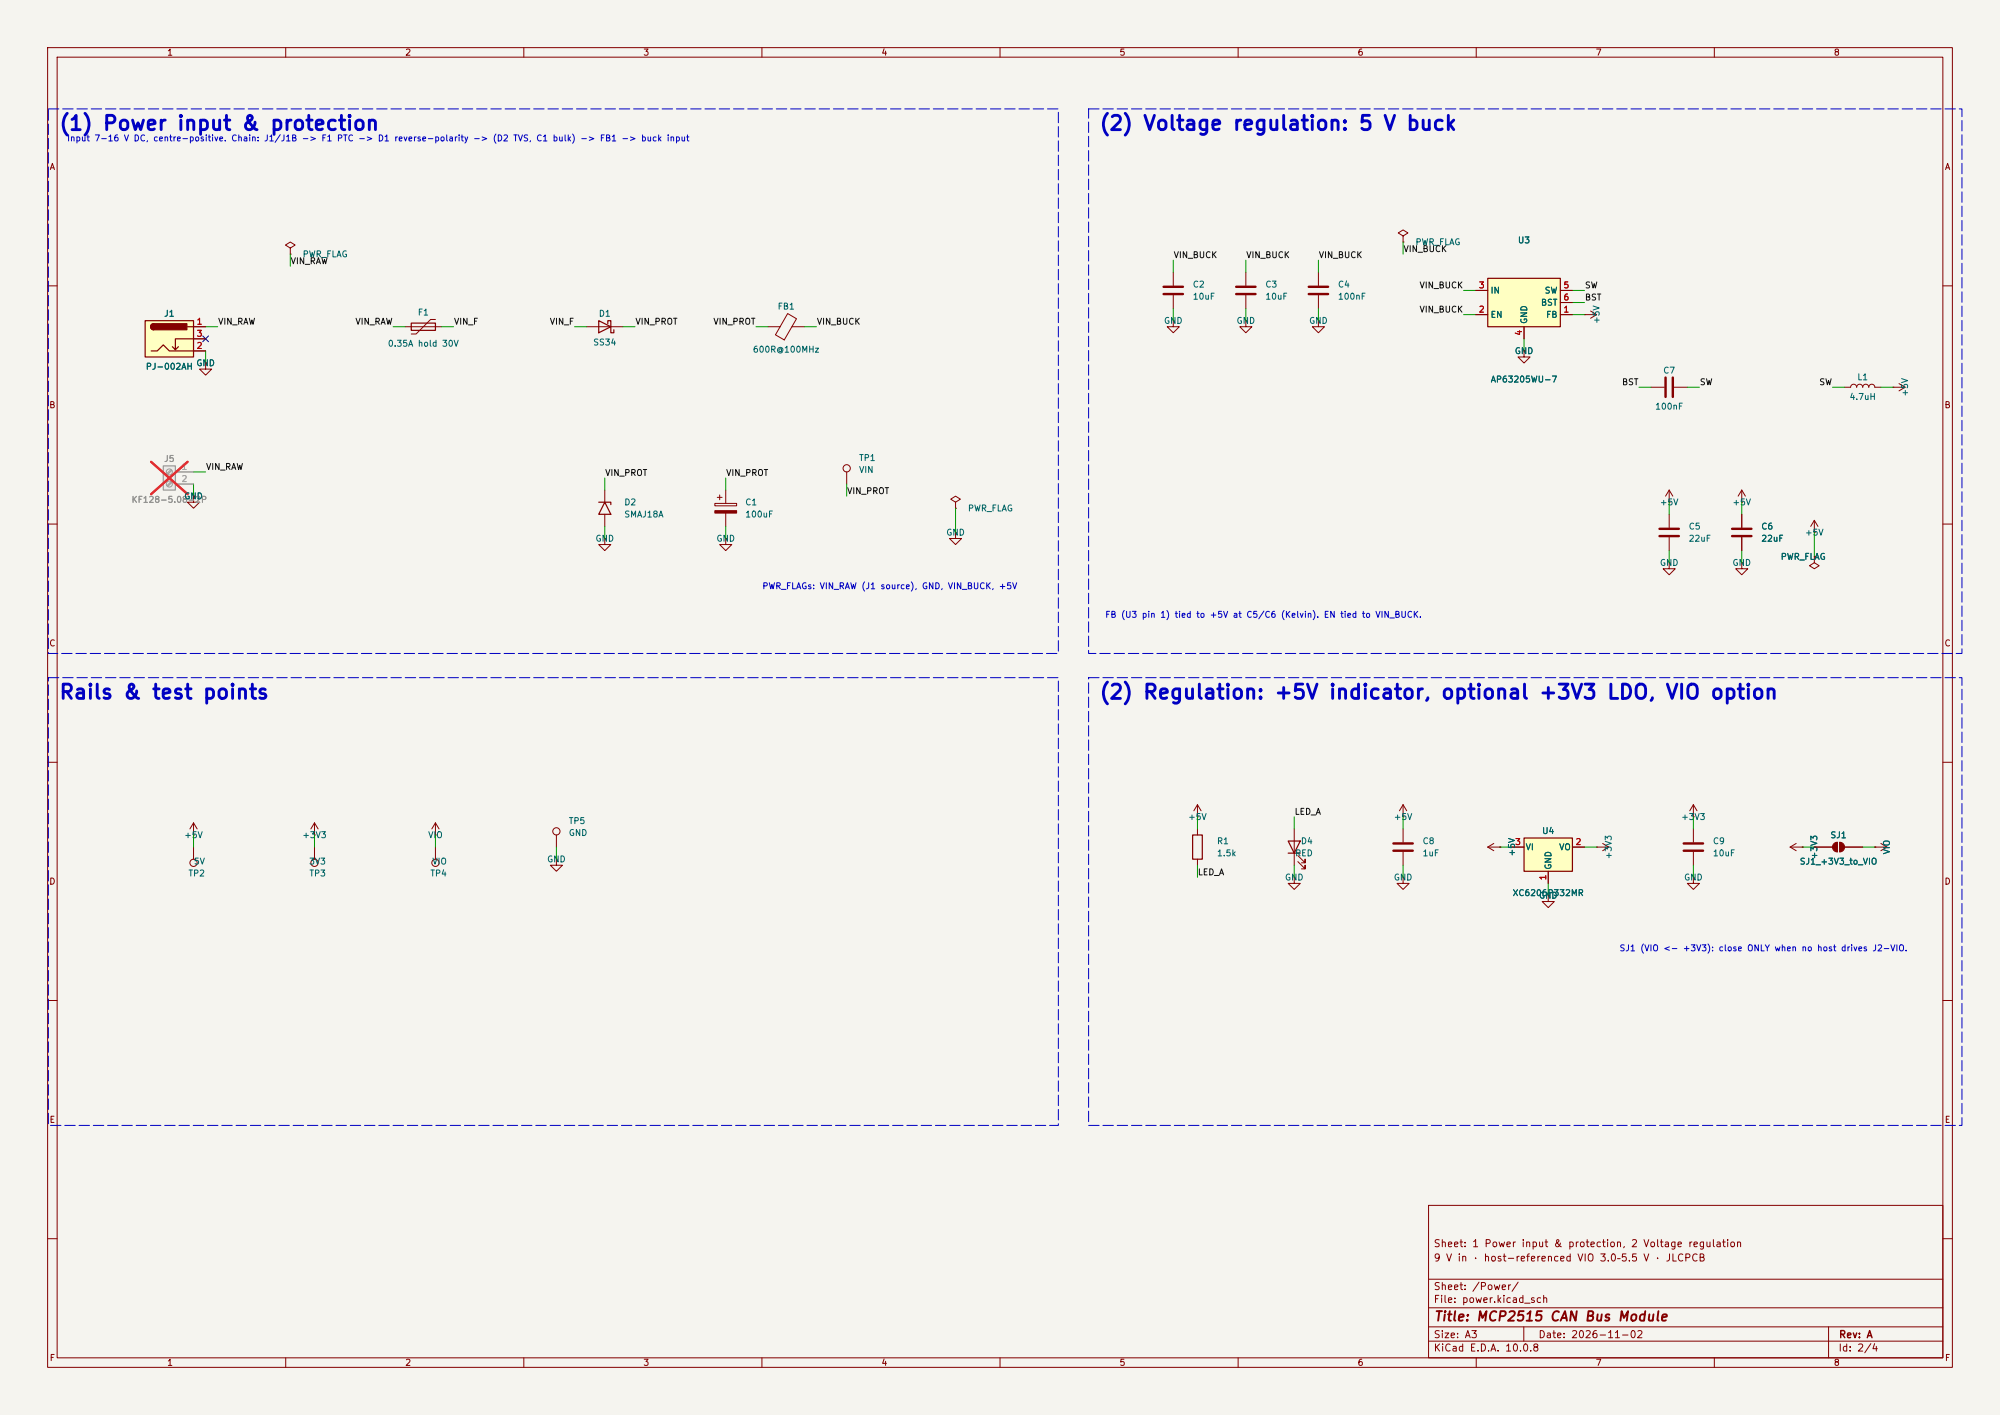
[picture p15: page 2]

Input 7-16 V DC, centre-positive. Chain: J1/J1B -> F1 PTC -> D1 reverse-polarity -> (D2 TVS, C1 bulk) -> FB1 -> buck input (1) Power input & protection

FB (U3 pin 1) tied to +5V at C5/C6 (Kelvin). EN tied to VIN_BUCK. (2) Voltage regulation: 5 V buck

Sheet: 1 Power input & protection, 2 Voltage regulation
9 V in · host-referenced VIO 3.0–5.5 V · JLCPCB

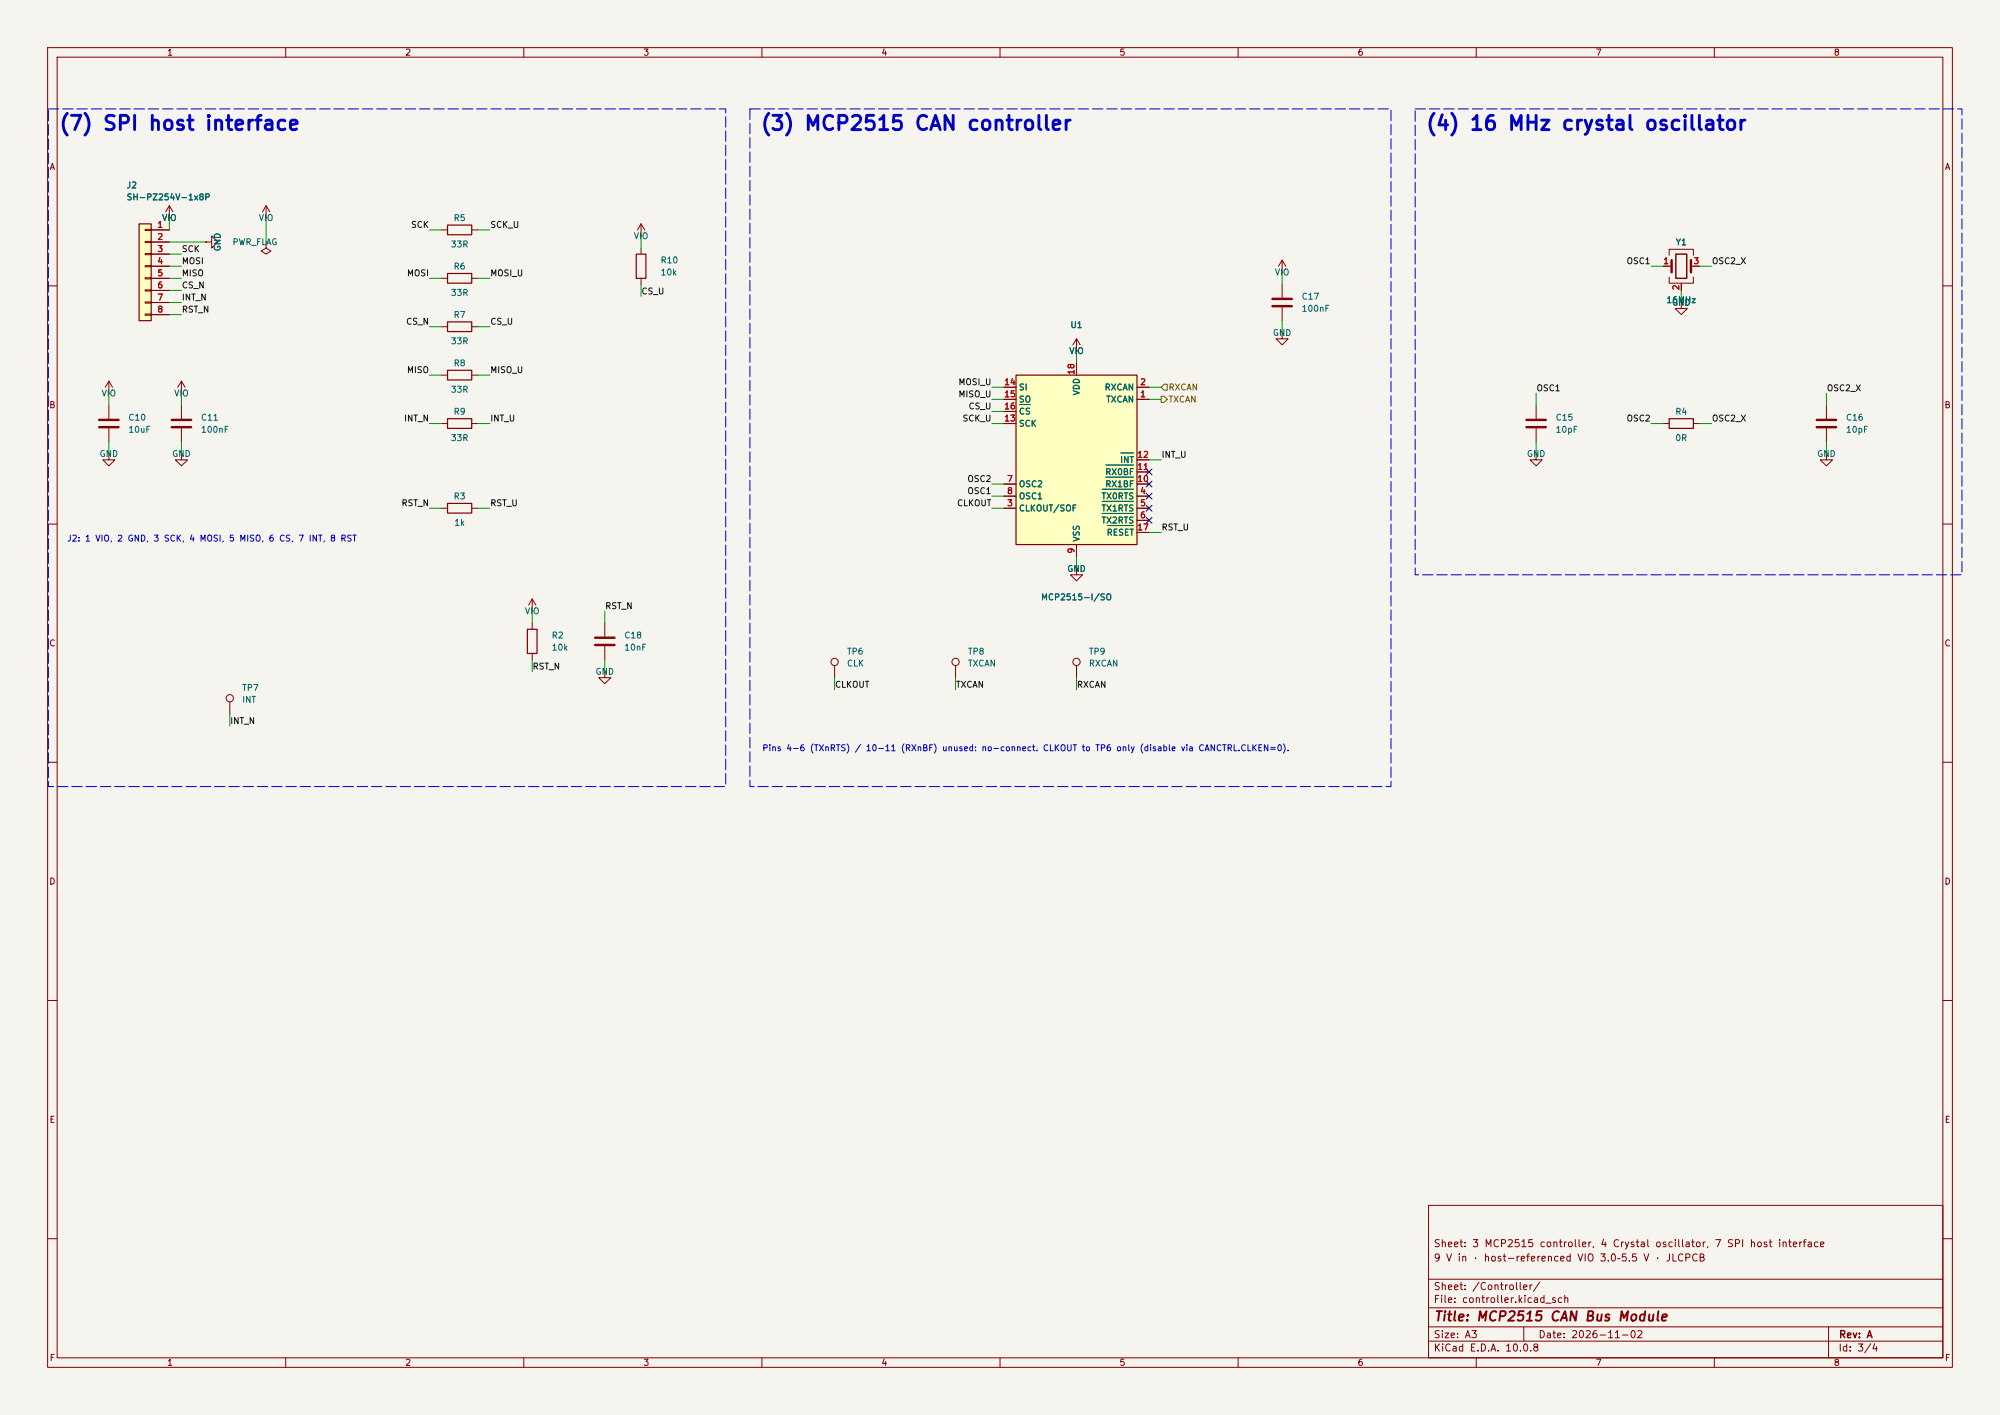
[picture p16: page 3]

Pins 4-6 (TXnRTS) / 10-11 (RXnBF) unused: no-connect. CLKOUT to TP6 only (disable via CANCTRL.CLKEN=0).

Sheet: 3 MCP2515 controller, 4 Crystal oscillator, 7 SPI host interface
9 V in · host-referenced VIO 3.0–5.5 V · JLCPCB

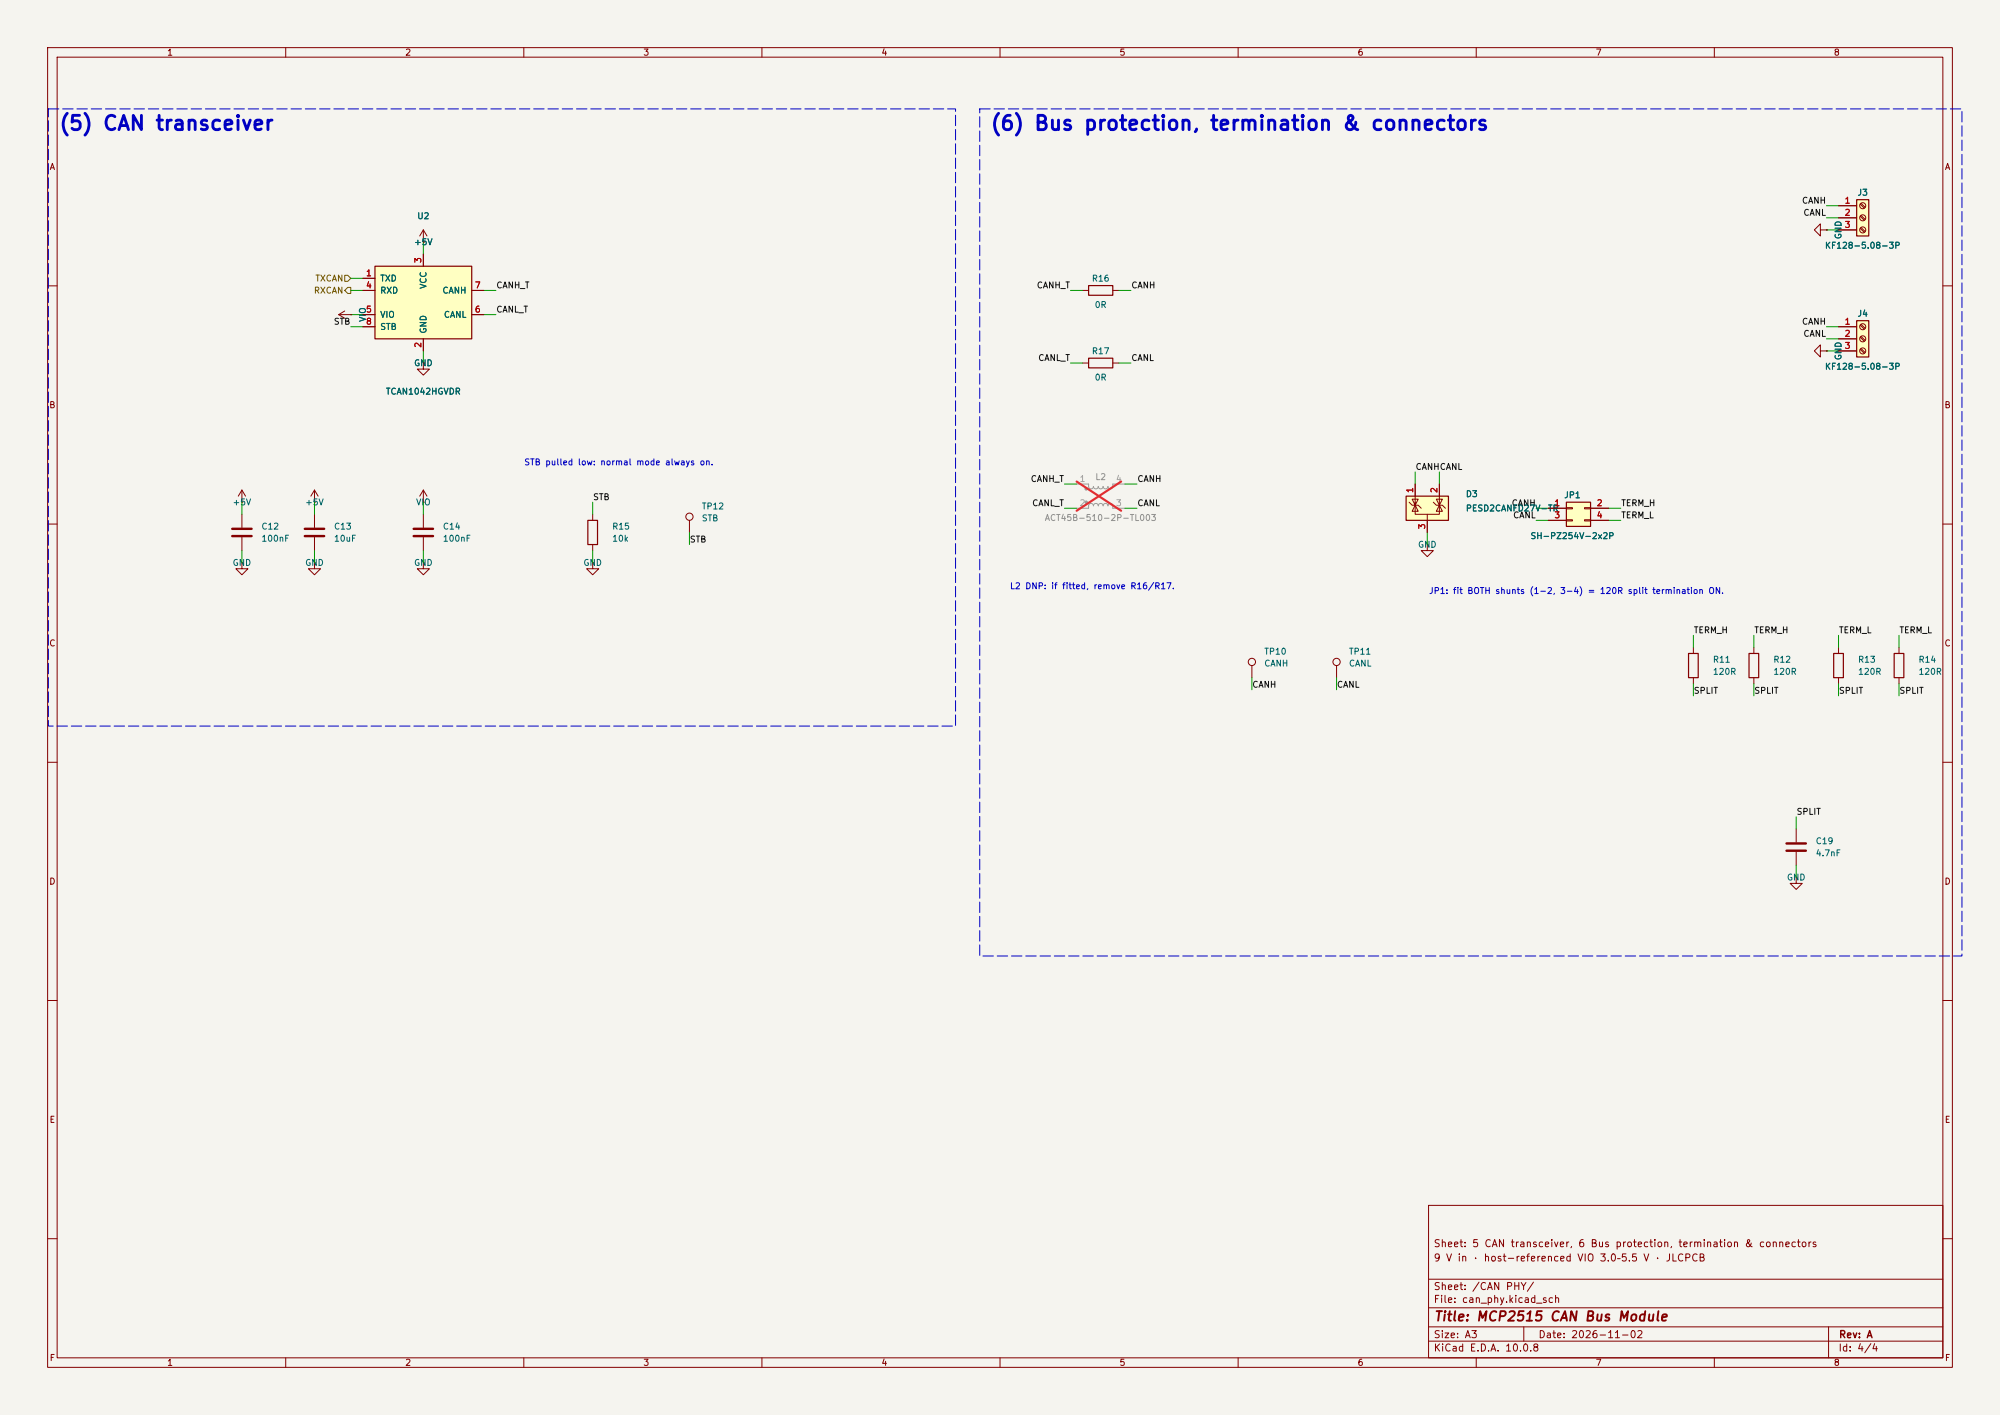
[picture p17: page 4]

Sheet: 5 CAN transceiver, 6 Bus protection, termination & connectors
9 V in · host-referenced VIO 3.0–5.5 V · JLCPCB
