jagathsrujan/mcp2515-can-bus-module/kicad/MCP2515_CAN/MCP2515_CAN.kicad_pcb

## KiCad design kicad/MCP2515_CAN/MCP2515_CAN.kicad_pcb (2026-11-03)

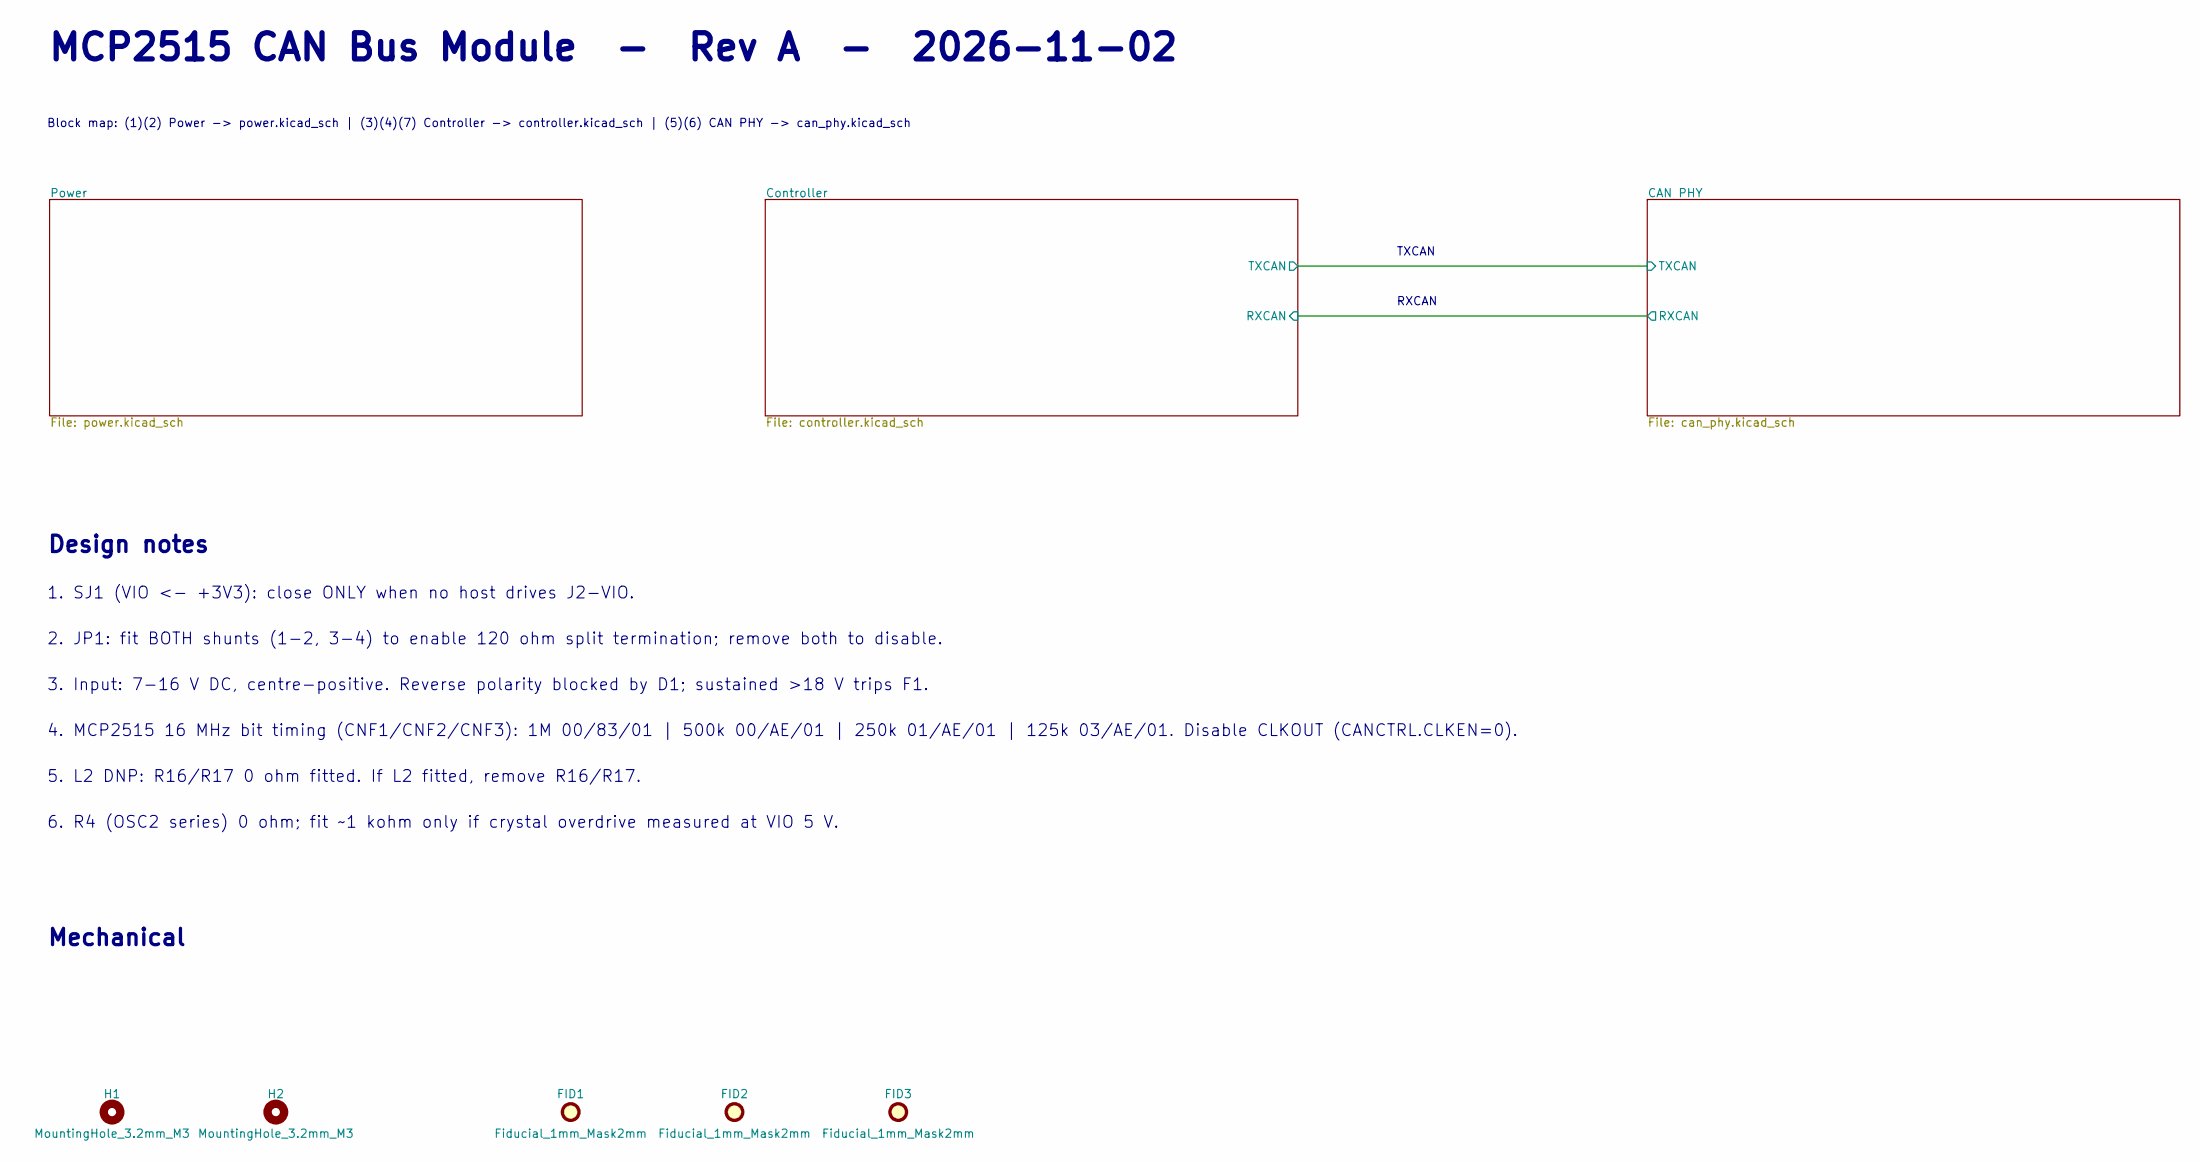
[picture p18: schematic MCP2515_CAN.kicad_sch, MCP2515 CAN Bus Module]

Parts:
FID1, FID2, FID3: Fiducial_1mm_Mask2mm
H1, H2: MountingHole_3.2mm_M3

Notes on the sheet:
TXCAN
RXCAN
MCP2515 CAN Bus Module - Rev A - 2026-11-02
Block map: (1)(2) Power -> power.kicad_sch | (3)(4)(7) Controller -> controller.kicad_sch | (5)(6) CAN PHY -> can_phy.kicad_sch
Design notes
1. SJ1 (VIO <- +3V3): close ONLY when no host drives J2-VIO.
2. JP1: fit BOTH shunts (1-2, 3-4) to enable 120 ohm split termination; remove both to disable.
3. Input: 7-16 V DC, centre-positive. Reverse polarity blocked by D1; sustained >18 V trips F1.
4. MCP2515 16 MHz bit timing (CNF1/CNF2/CNF3): 1M 00/83/01 | 500k 00/AE/01 | 250k 01/AE/01 | 125k 03/AE/01. Disable CLKOUT (CANCTRL.CLKEN=0).
5. L2 DNP: R16/R17 0 ohm fitted. If L2 fitted, remove R16/R17.
6. R4 (OSC2 series) 0 ohm; fit ~1 kohm only if crystal overdrive measured at VIO 5 V.
Mechanical

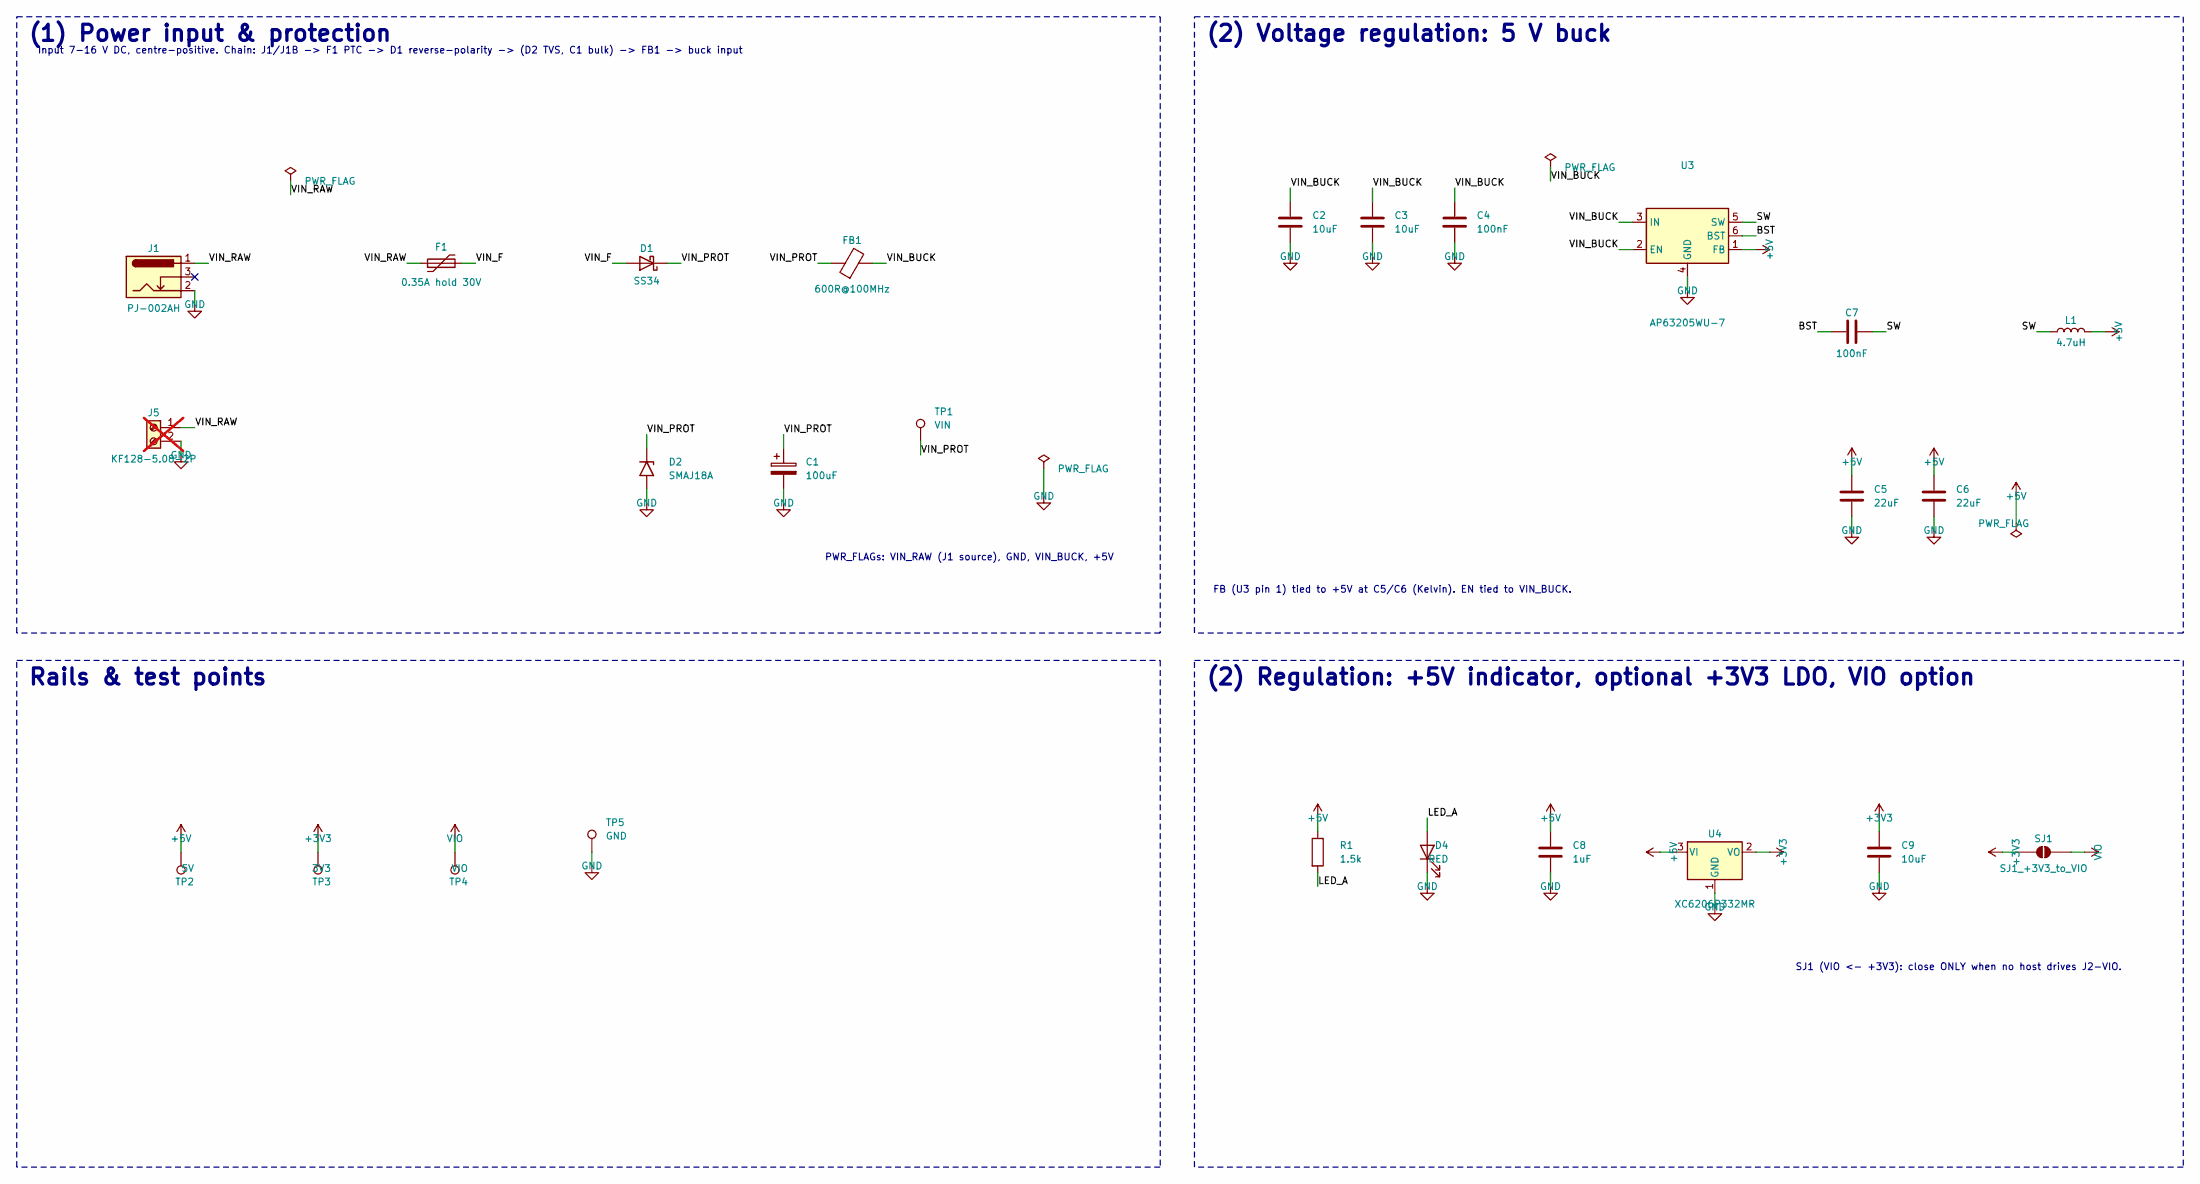
[picture p19: schematic power.kicad_sch, MCP2515 CAN Bus Module]

Parts:
C1: 100uF; CP_Elec_6.3x7.7; MPN FZ100UF35V90RV0064; LCSC C2992596
C2, C3: 10uF; C_1206_3216Metric; MPN CL31A106KBHNNNE; LCSC C13585
C4, C7: 100nF; C_0603_1608Metric; MPN CC0603KRX7R9BB104; LCSC C14663
C5, C6: 22uF; C_1206_3216Metric; MPN CL31A226KAHNNNE; LCSC C12891
C8: 1uF; C_0603_1608Metric; MPN CL10A105KB8NNNC; LCSC C15849
C9: 10uF; C_0805_2012Metric; MPN CL21A106KAYNNNE; LCSC C15850
D1: SS34; D_SMA; MPN SS34; LCSC C8678
D2: SMAJ18A; D_SMA; MPN SMAJ18A; LCSC C148219
D4: RED; LED_0603_1608Metric; MPN KT-0603R; LCSC C2286
F1: 0.35A hold 30V; Fuse_1206_3216Metric; MPN 0ZCJ0035AF2E; LCSC C6378052
FB1: 600R@100MHz; L_0805_2012Metric; MPN GZ2012D601TF; LCSC C1017
J1: PJ-002AH; BarrelJack_CUI_PJ-002AH; MPN PJ-002AH; LCSC C2961147
J5: KF128-5.08-2P; KF128-5.08-2P_Horizontal; MPN KF128-5.08-2P; LCSC C474952; not fitted
L1: 4.7uH; L_Sunlord_SWPA4020S; MPN SWPA4020S4R7MT; LCSC C48427
R1: 1.5k; R_0603_1608Metric; MPN 0603WAF1501T5E; LCSC C22843
SJ1: SJ1_+3V3_to_VIO; SolderJumper-2_P1.3mm_Open_RoundedPad1.0x1.5mm
TP1: VIN; TestPoint_Pad_D1.5mm
TP2: 5V; TestPoint_Pad_D1.5mm
TP3: 3V3; TestPoint_Pad_D1.5mm
TP4: VIO; TestPoint_Pad_D1.5mm
TP5: GND; TestPoint_Pad_D1.5mm
U3: AP63205WU-7; TSOT-23-6; MPN AP63205WU-7; LCSC C2071056
U4: XC6206P332MR; SOT-23-3; MPN XC6206P332MR; LCSC C5446

Connections:
+3V3: C9.1, SJ1.1 (A), TP3.1, U4.2 (VO)
+5V: C5.1, C6.1, C8.1, L1.2, R1.1, TP2.1, U3.1 (FB), U4.3 (VI); also elsewhere on the board
/Power/BST: C7.1, U3.6 (BST)
/Power/LED_A: D4.2 (A), R1.2
/Power/SW: C7.2, L1.1, U3.5 (SW)
/Power/VIN_BUCK: C2.1, C3.1, C4.1, FB1.2, U3.2 (EN), U3.3 (IN)
/Power/VIN_F: D1.2 (A), F1.2
/Power/VIN_PROT: C1.1, D1.1 (K), D2.1 (A1), FB1.1, TP1.1
/Power/VIN_RAW: F1.1, J1.1, J5.1
GND: C1.2, C2.2, C3.2, C4.2, C5.2, C6.2, C8.2, C9.2, D2.2 (A2), D4.1 (K), J1.2, J5.2, TP5.1, U3.4 (GND), U4.1 (GND); also elsewhere on the board
VIO: SJ1.2 (B), TP4.1; also elsewhere on the board

Notes on the sheet:
(1) Power input & protection
Input 7-16 V DC, centre-positive. Chain: J1/J1B -> F1 PTC -> D1 reverse-polarity -> (D2 TVS, C1 bulk) -> FB1 -> buck input
PWR_FLAGs: VIN_RAW (J1 source), GND, VIN_BUCK, +5V
(2) Voltage regulation: 5 V buck
FB (U3 pin 1) tied to +5V at C5/C6 (Kelvin). EN tied to VIN_BUCK.
Rails & test points
(2) Regulation: +5V indicator, optional +3V3 LDO, VIO option
SJ1 (VIO <- +3V3): close ONLY when no host drives J2-VIO.

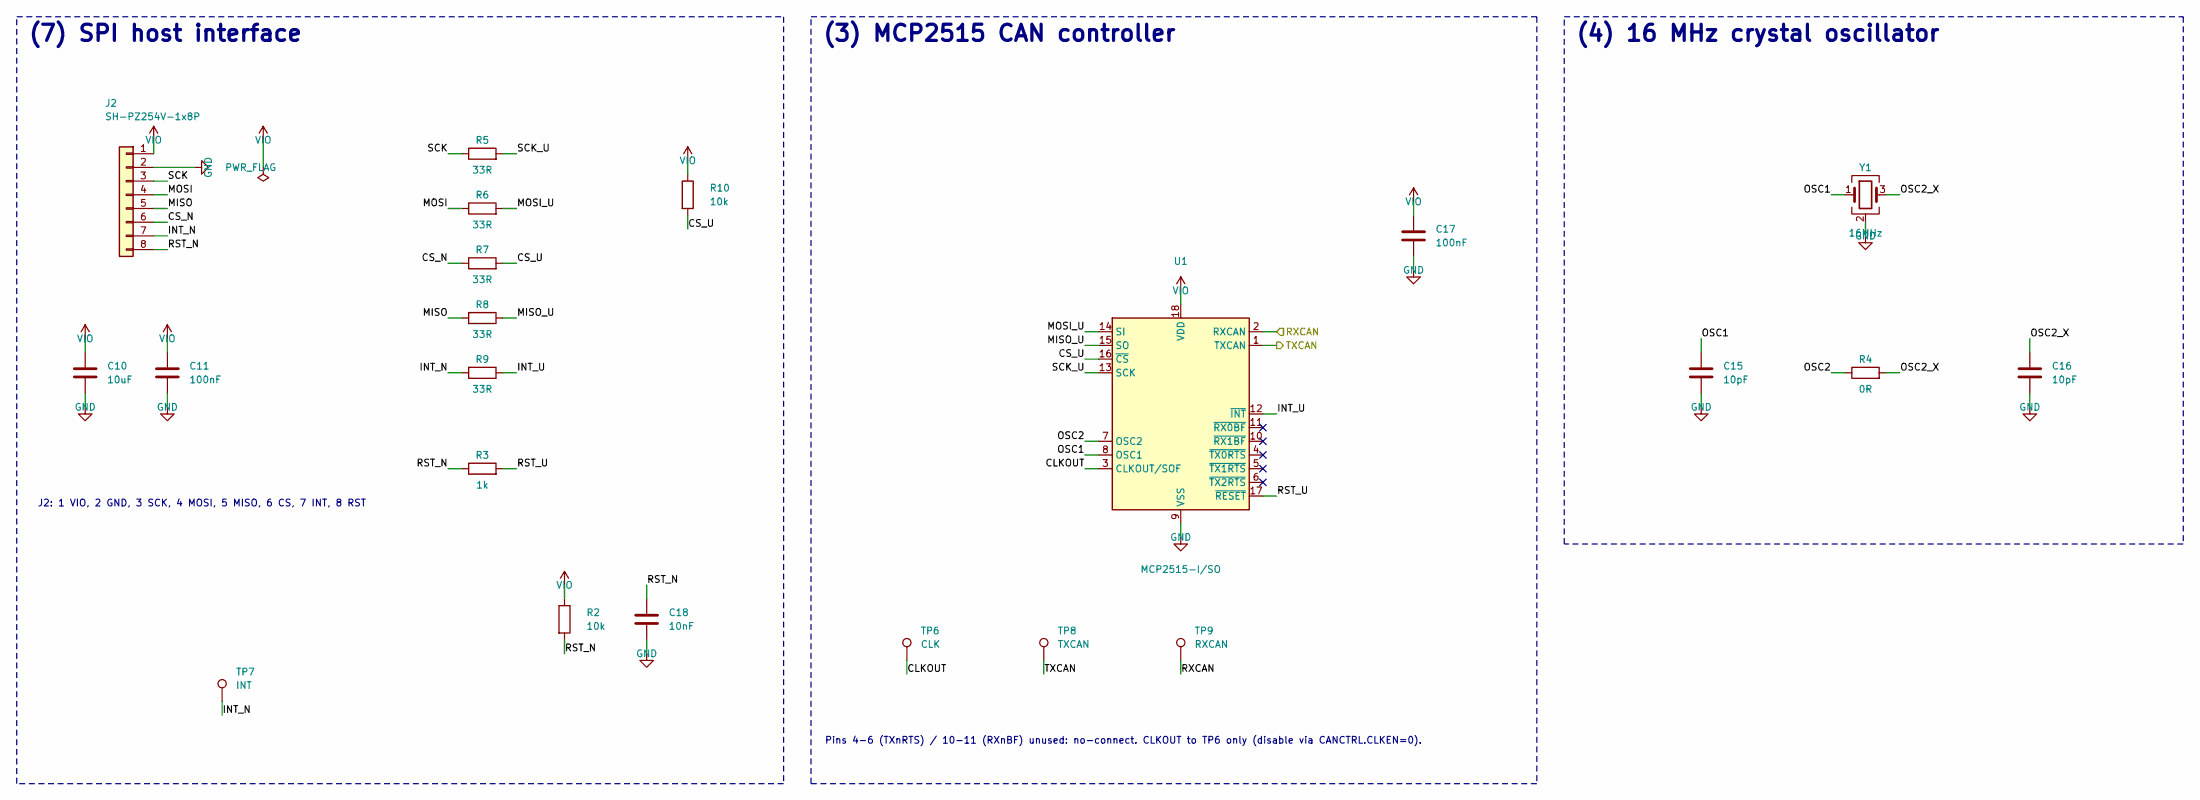
[picture p20: schematic controller.kicad_sch, MCP2515 CAN Bus Module]

Parts:
C10: 10uF; C_0805_2012Metric; MPN CL21A106KAYNNNE; LCSC C15850
C11, C17: 100nF; C_0603_1608Metric; MPN CC0603KRX7R9BB104; LCSC C14663
C15, C16: 10pF; C_0603_1608Metric; MPN CL10C100JB8NNNC; LCSC C1634
C18: 10nF; C_0603_1608Metric; MPN 0603B103K500NT; LCSC C57112
J2: SH-PZ254V-1x8P; PinHeader_1x08_P2.54mm_Vertical; MPN SH-PZ254V-1x8P; LCSC C55629815
R2, R10: 10k; R_0603_1608Metric; MPN 0603WAF1002T5E; LCSC C25804
R3: 1k; R_0603_1608Metric; MPN 0603WAF1001T5E; LCSC C21190
R4: 0R; R_0603_1608Metric; MPN 0603WAF0000T5E; LCSC C21189
R5, R6, R7, R8, R9: 33R; R_0603_1608Metric; MPN 0603WAF330JT5E; LCSC C23140
TP6: CLK; TestPoint_Pad_D1.5mm
TP7: INT; TestPoint_Pad_D1.5mm
TP8: TXCAN; TestPoint_Pad_D1.5mm
TP9: RXCAN; TestPoint_Pad_D1.5mm
U1: MCP2515-I/SO; SOIC-18W_7.5x11.6mm_P1.27mm; MPN MCP2515T-I/SO; LCSC C153782
Y1: 16MHz; Crystal_SMD_3225-4Pin_3.2x2.5mm; MPN X322516MLB4SI; LCSC C13738

Connections:
/Controller/CLKOUT: TP6.1, U1.3 (CLKOUT/SOF)
/Controller/CS_N: J2.6, R7.1
/Controller/CS_U: R7.2, R10.2, U1.16 (~CS)
/Controller/INT_N: J2.7, R9.2, TP7.1
/Controller/INT_U: R9.1, U1.12 (~INT)
/Controller/MISO: J2.5, R8.2
/Controller/MISO_U: R8.1, U1.15 (SO)
/Controller/MOSI: J2.4, R6.1
/Controller/MOSI_U: R6.2, U1.14 (SI)
/Controller/OSC1: C15.1, U1.8 (OSC1), Y1.1
/Controller/OSC2: R4.1, U1.7 (OSC2)
/Controller/OSC2_X: C16.1, R4.2, Y1.3
/Controller/RST_N: C18.1, J2.8, R2.2, R3.1
/Controller/RST_U: R3.2, U1.17 (~RESET)
/Controller/RXCAN: TP9.1, U1.2 (RXCAN); also elsewhere on the board
/Controller/SCK: J2.3, R5.1
/Controller/SCK_U: R5.2, U1.13 (SCK)
/Controller/TXCAN: TP8.1, U1.1 (TXCAN); also elsewhere on the board
GND: C10.2, C11.2, C15.2, C16.2, C17.2, C18.2, J2.2, U1.9 (VSS), Y1.2 (G), Y1.4 (G); also elsewhere on the board
VIO: C10.1, C11.1, C17.1, J2.1, R2.1, R10.1, U1.18 (VDD); also elsewhere on the board

Notes on the sheet:
(7) SPI host interface
J2: 1 VIO, 2 GND, 3 SCK, 4 MOSI, 5 MISO, 6 CS, 7 INT, 8 RST
(3) MCP2515 CAN controller
Pins 4-6 (TXnRTS) / 10-11 (RXnBF) unused: no-connect. CLKOUT to TP6 only (disable via CANCTRL.CLKEN=0).
(4) 16 MHz crystal oscillator

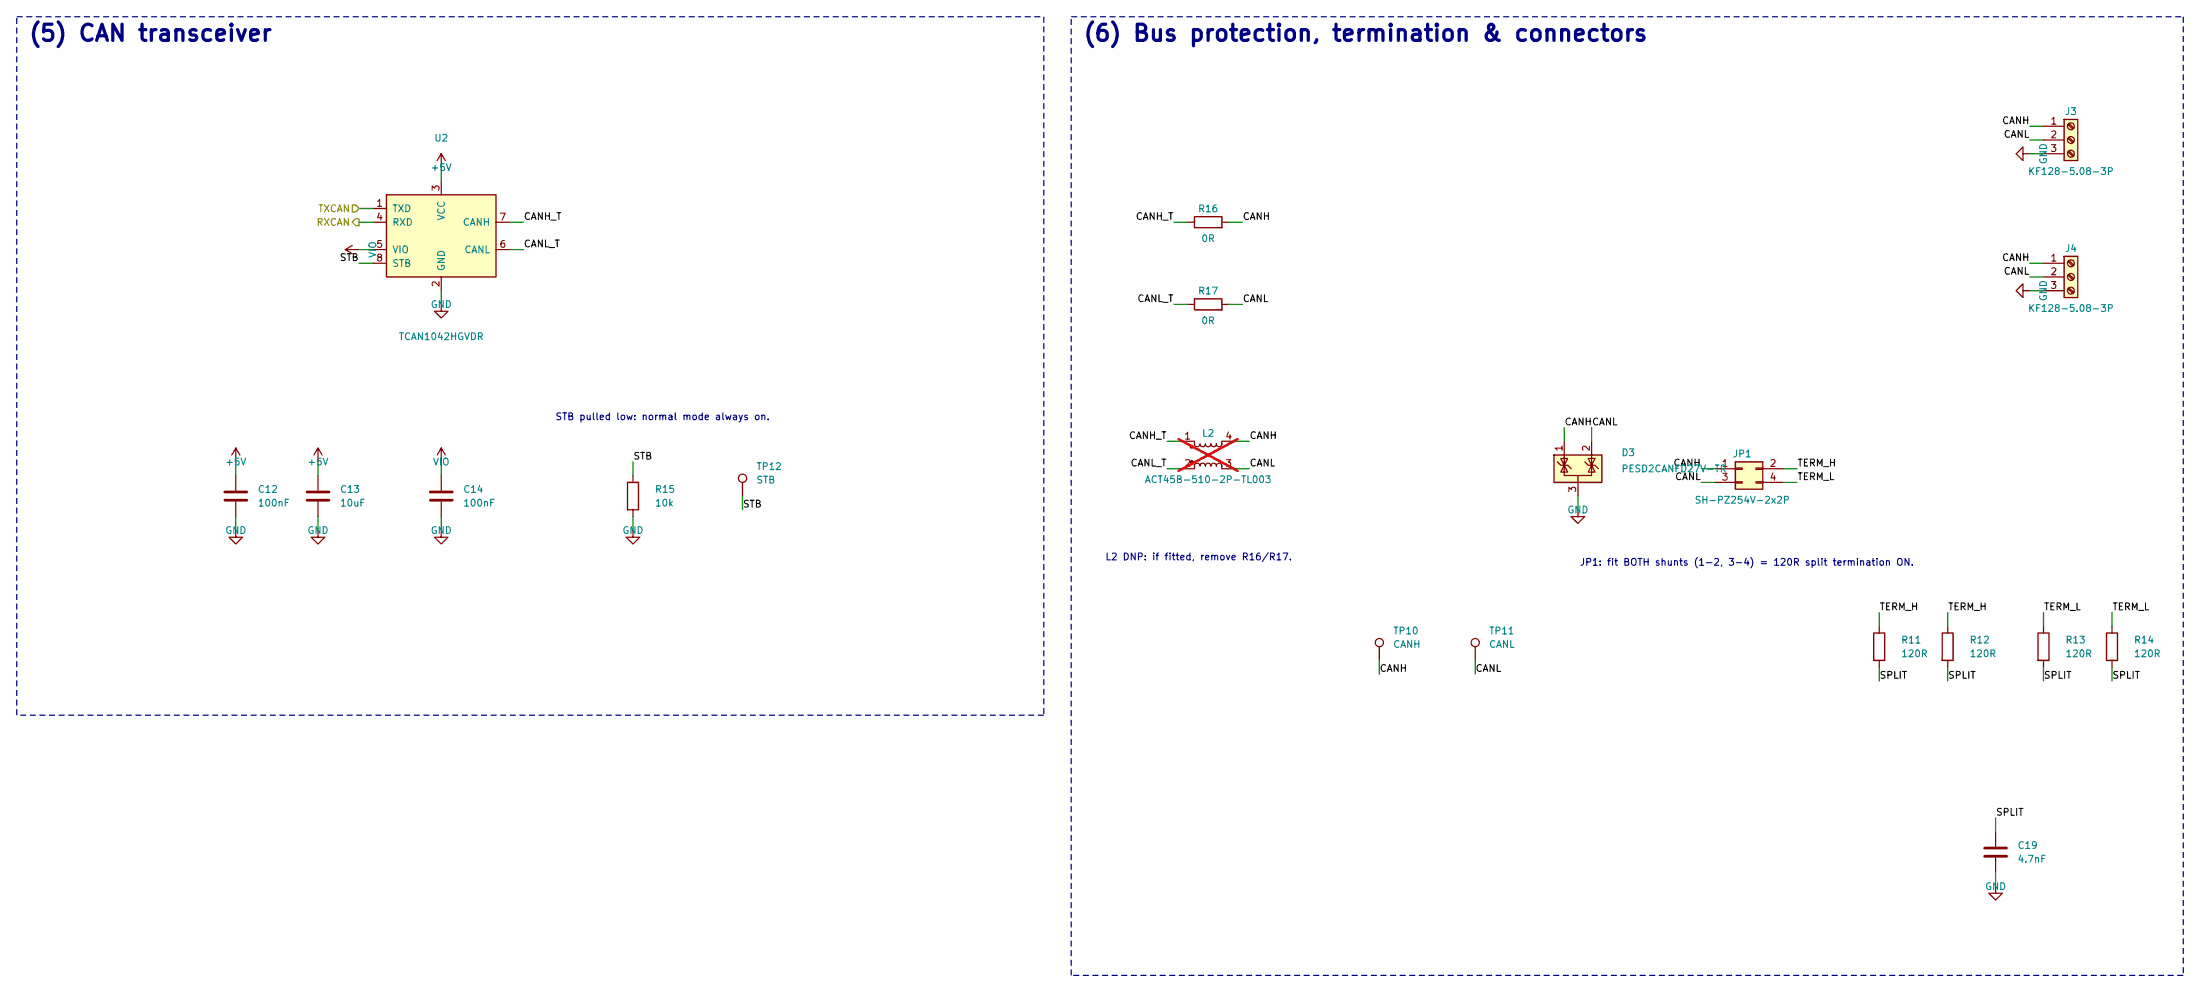
[picture p21: schematic can_phy.kicad_sch, MCP2515 CAN Bus Module]

Parts:
C12, C14: 100nF; C_0603_1608Metric; MPN CC0603KRX7R9BB104; LCSC C14663
C13: 10uF; C_0805_2012Metric; MPN CL21A106KAYNNNE; LCSC C15850
C19: 4.7nF; C_0603_1608Metric; MPN 0603B472K500NT; LCSC C53987
D3: PESD2CANFD27V-TR; SOT-23; MPN PESD2CANFD27V-TR; LCSC C552488
J3, J4: KF128-5.08-3P; KF128-5.08-3P_Horizontal; MPN KF128-5.08-3P; LCSC C474953
JP1: SH-PZ254V-2x2P; PinHeader_2x02_P2.54mm_Vertical; MPN SH-PZ254V-2x2P; LCSC C55629823
L2: ACT45B-510-2P-TL003; L_CommonModeChoke_TDK_ACT45B; MPN ACT45B-510-2P-TL003; LCSC C76584; not fitted
R11, R12, R13, R14: 120R; R_0603_1608Metric; MPN 0603WAF1200T5E; LCSC C22787
R15: 10k; R_0603_1608Metric; MPN 0603WAF1002T5E; LCSC C25804
R16, R17: 0R; R_0603_1608Metric; MPN 0603WAF0000T5E; LCSC C21189
TP10: CANH; TestPoint_Pad_D1.5mm
TP11: CANL; TestPoint_Pad_D1.5mm
TP12: STB; TestPoint_Pad_D1.5mm
U2: TCAN1042HGVDR; SOIC-8_3.9x4.9mm_P1.27mm; MPN TCAN1042HGVDR; LCSC C124014

Connections:
+5V: C12.1, C13.1, U2.3 (VCC); also elsewhere on the board
/CAN PHY/CANH: D3.1 (K), J3.1, J4.1, JP1.1, L2.4, R16.2, TP10.1
/CAN PHY/CANH_T: L2.1, R16.1, U2.7 (CANH)
/CAN PHY/CANL: D3.2 (K), J3.2, J4.2, JP1.3, L2.3, R17.2, TP11.1
/CAN PHY/CANL_T: L2.2, R17.1, U2.6 (CANL)
/CAN PHY/SPLIT: C19.1, R11.2, R12.2, R13.2, R14.2
/CAN PHY/STB: R15.1, TP12.1, U2.8 (STB)
/CAN PHY/TERM_H: JP1.2, R11.1, R12.1
/CAN PHY/TERM_L: JP1.4, R13.1, R14.1
/Controller/RXCAN: U2.4 (RXD); also elsewhere on the board
/Controller/TXCAN: U2.1 (TXD); also elsewhere on the board
GND: C12.2, C13.2, C14.2, C19.2, D3.3 (A), J3.3, J4.3, R15.2, U2.2 (GND); also elsewhere on the board
VIO: C14.1, U2.5 (VIO); also elsewhere on the board

Notes on the sheet:
(5) CAN transceiver
STB pulled low: normal mode always on.
(6) Bus protection, termination & connectors
L2 DNP: if fitted, remove R16/R17.
JP1: fit BOTH shunts (1-2, 3-4) = 120R split termination ON.

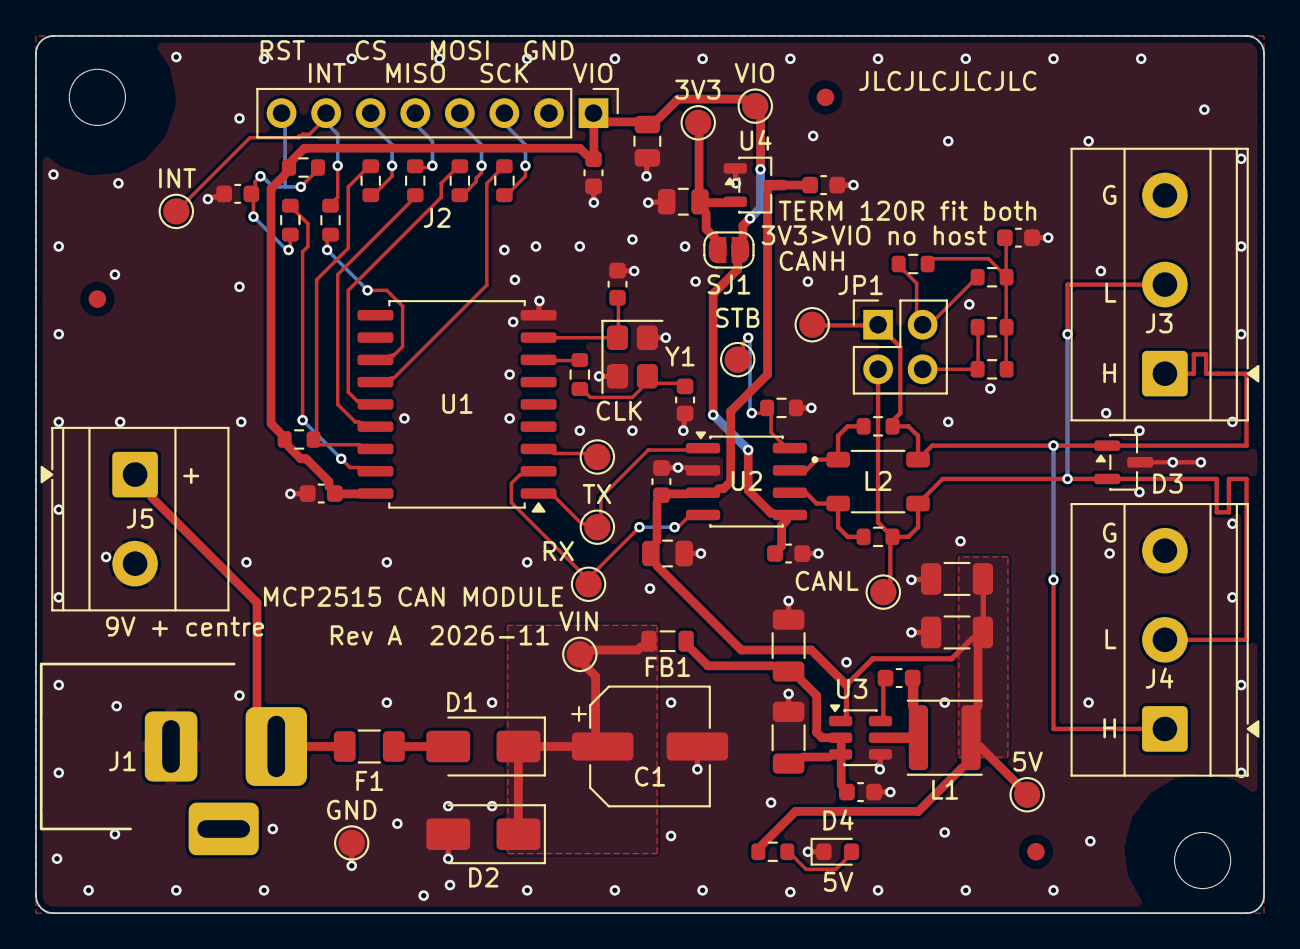
[picture p22: board MCP2515_CAN.kicad_pcb from above]

Board: 2 copper layers, 70.0 x 50.0 mm, 73 parts (0 on the bottom side), 37 nets.
