jagathsrujan/mcp2515-can-bus-module/(commit log)

2026-11-02 Snapshot of design progress: spec, phase 2-3 docs, BOM, research
    [BOM_master.csv, power_budget.xlsx]
2026-11-02 Progress update: phases 4-5 docs, phase 6 schematic plan
    [BOM_master.csv]
2026-11-03 Progress update: schematic, PCB layout, manufacturing files, final validation (Rev A)
    [BOM_final.csv, BOM_final.xlsx, BOM_master.csv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]
